antoxa78/Matrix_Clock_v3/(list of files, cad)

Other CAD files:
hardware/滤光板/挡板1.dwg
