antoxa78/Matrix_Clock_v3/sch.PDF

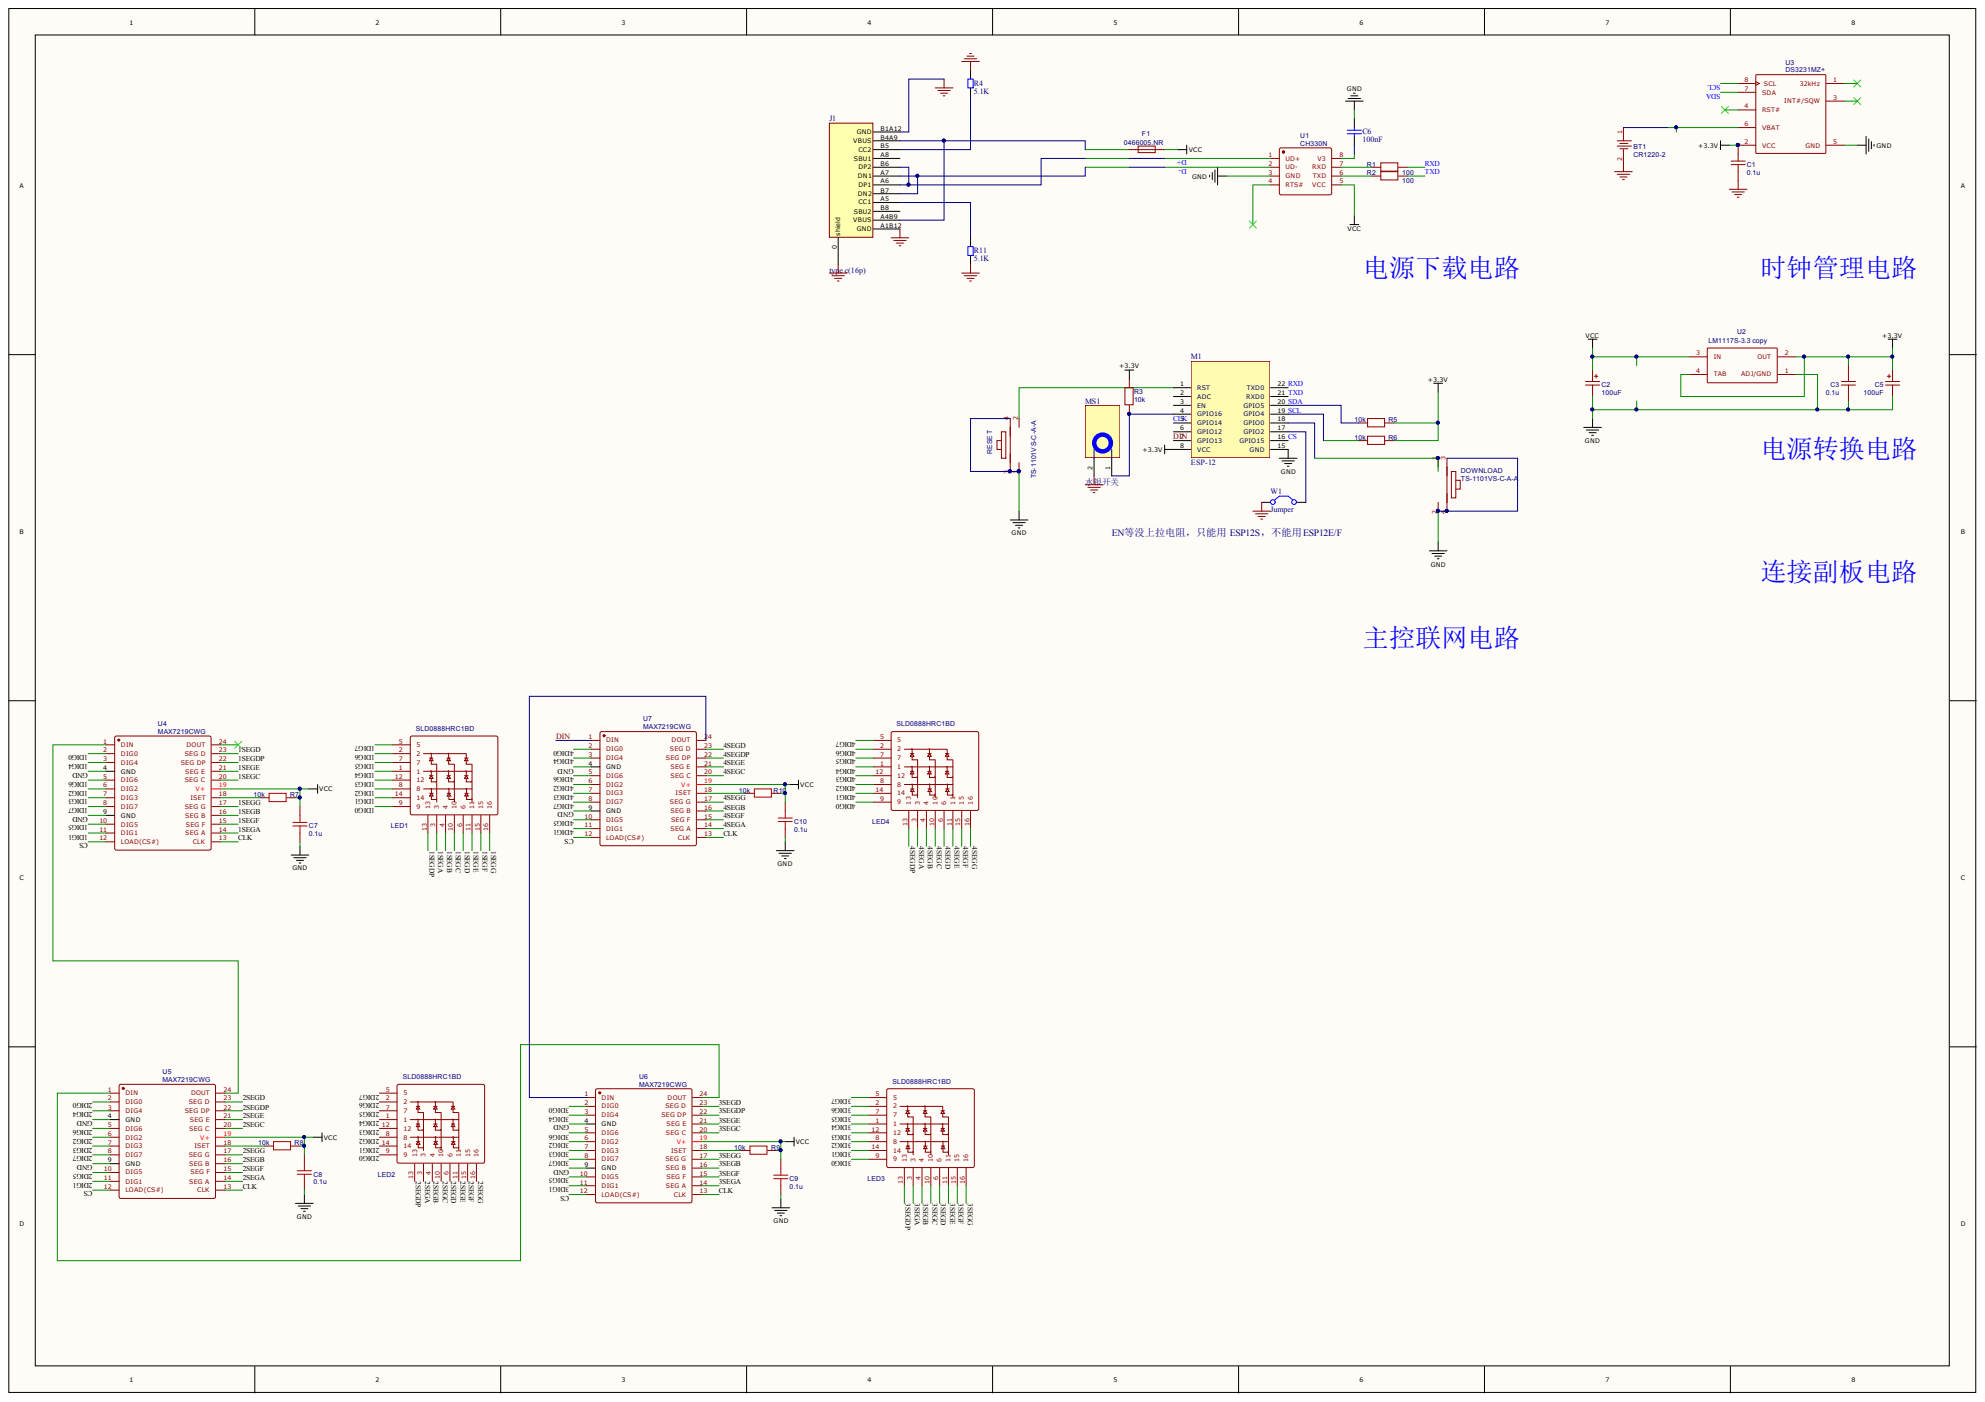
[picture p1: page 1]

R3 10k MS1 | | ADC 2

GPIO16 4 | | SCL
CLK | GPIO14 5
GPIO12 6 | | | 10k | R6
DIN | GPIO13 7 | | CS

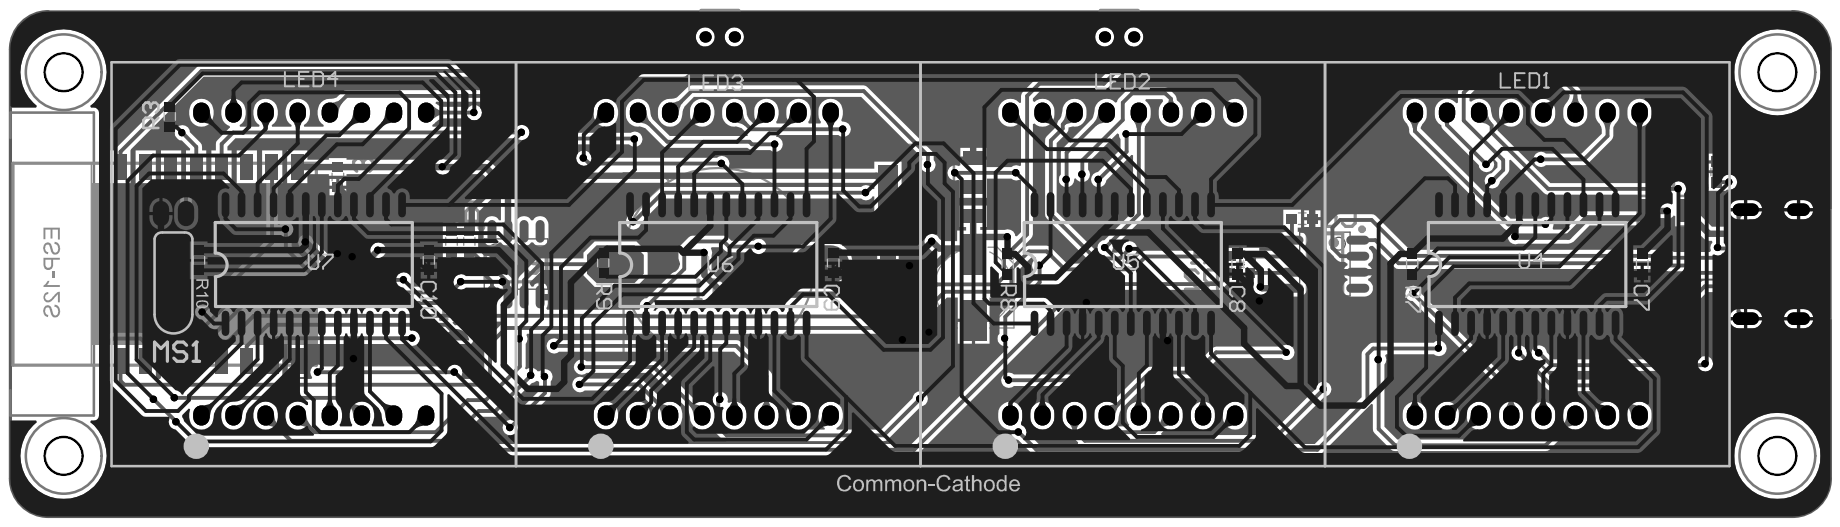
[picture p2: page 2]

Comment | Description | Designator | Footprint | LibRef | Quantity
CR1220-2 | | BT1 | CR1220座 | CR1220-2 | 1
0.1u | | C1, C3, C7, C8, C9, C10 | 0603(RC1608) | 0.1u | 6
100uF | | C2 | 6mm贴片电解 | 100uF | 1
100uF | | C5 | 0805(RC2012) | 100uF | 1
Cap | Capacitor | C6 | 0603(RC1608) | Cap | 1
TS-1101VS-C-A-A | | DOWNLOAD, RESET | KEY-SMD_4P-L7.8-W2.8-P4.20-EH | TS-1101VS-C-A-A | 2
0466005.NR | | F1 | LC-1206_R | 0466005.NR | 1
type c(16p) | | J1 | Type C(16P) | type c(16p) | 1
SLD0888HRC1BD | | LED1, LED2, LED3, LED4 | F3.0 LED DOT MATRIX | SLD0888HRC1BD | 4
ESP-12 | | M1 | ESP-12F贴片简化 | ESP-12 | 1
水银开关 | | MS1 | 水银开关2 | 水银开关 | 1
100 | | R1, R2 | 0603(RC1608) | 100 | 2
10k | | R3, R5, R6, R7, R8, R9, R10 | 0603(RC1608) | 10k | 7
5.1K | | R4, R11 | 0603(RC1608) | RES2 | 2
CH330N | | U1 | LC-SOP-8_150mil | CH330N | 1
LM1117S-3.3 copy | | U2 | SOT-223 | LM1117S-3.3 copy | 1
DS3231MZ+ | | U3 | LC-SOP-8_150mil | DS3231MZ+ | 1
MAX7219CWG | | U4, U5, U6, U7 | SOIC-24_L15.4-W7.5-P1.27-LS10.3-BL | MAX7219CWG | 4
Jumper | Jumper Wire | W1 | 跳线焊盘 | Jumper | 1
