antoxa78/Matrix_Clock_v3/hardware/hack_clock.kicad_pcb

## KiCad design hardware/hack_clock.kicad_pcb (2026-08-15)

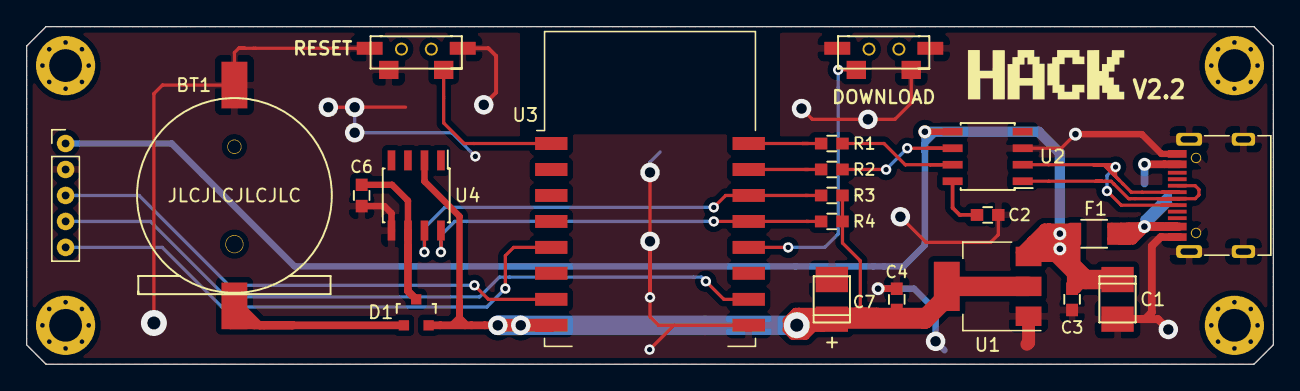
[picture p3: board hack_clock.kicad_pcb from above]

Board: 2 copper layers, 96.0 x 26.0 mm, 23 parts (1 on the bottom side), 20 nets.

Parts:
BT1: BATTERY(M); CR1220-SMD
C1, C7: 100uF; TantalC_SizeT_3528
C2, C6: 0.1uF; 0603_C
C3, C4: 1uF; 0603_C
D1: BAT54C; SOT-23
F1: FUSE*; F_1206
J1: Conn_01x05_Male; PinHeader_1x05_P2.00mm_Vertical
J2: Jack-DC; BarrelJack_DCDC-SMT
P3: USB_C_Plug_USB2.0; USB-Type-C-NEW
P665: CON_1; CON1
R1, R2: RES(M); 0603_R
R3, R4: 10K; 0603_R
SW1, SW2: switch; SWITCH_PUSH
U1: AMS1117; SOT-223-3_TabPin2
U2: CH340N; SOP-8
U3: ESP-12; ESP-12S
U4: DS3231MZ+; SOP-8

Connections:
+3V3: C4.2, C7.1, D1.2, R3.2, R4.2, U1.2, U3.8, U4.2
+5V: C1.1, C3.2, F1.2, J1.1, U1.3, U2.5
/CLK: J1.5, U3.5
/CS: J1.4, U3.16
/DIN: J1.3, U3.7
/RXD: R1.2, U3.22
/SCL: R4.1, U3.19, U4.8
/SDA: R3.1, U3.20, U4.7
/TXD: R2.2, U3.21
/USB_D+: P3.A6, U2.1
/USB_D-: P3.A7, U2.2
GND: BT1.2, C1.2, C2.1, C3.1, C4.1, C6.1, C7.2, J1.2, J2.2, P3.A1, P3.S1, SW1.1, SW2.1, U1.1, U2.3, U3.15, U4.5
unnamed: BT1.1, D1.1
unnamed: C2.2, U2.8
unnamed: C6.2, D1.3, U4.6
unnamed: F1.1, J2.1, P3.A4
unnamed: R1.1, U2.7
unnamed: R2.1, U2.6
unnamed: SW1.2, U3.1
unnamed: SW2.2, U3.18
