antoxa78/Matrix_Clock_v3/hardware/matrix display_v2.1/matrix_display.kicad_pcb

## KiCad design hardware/matrix display_v2.1/matrix_display.kicad_pcb (2026-08-15)

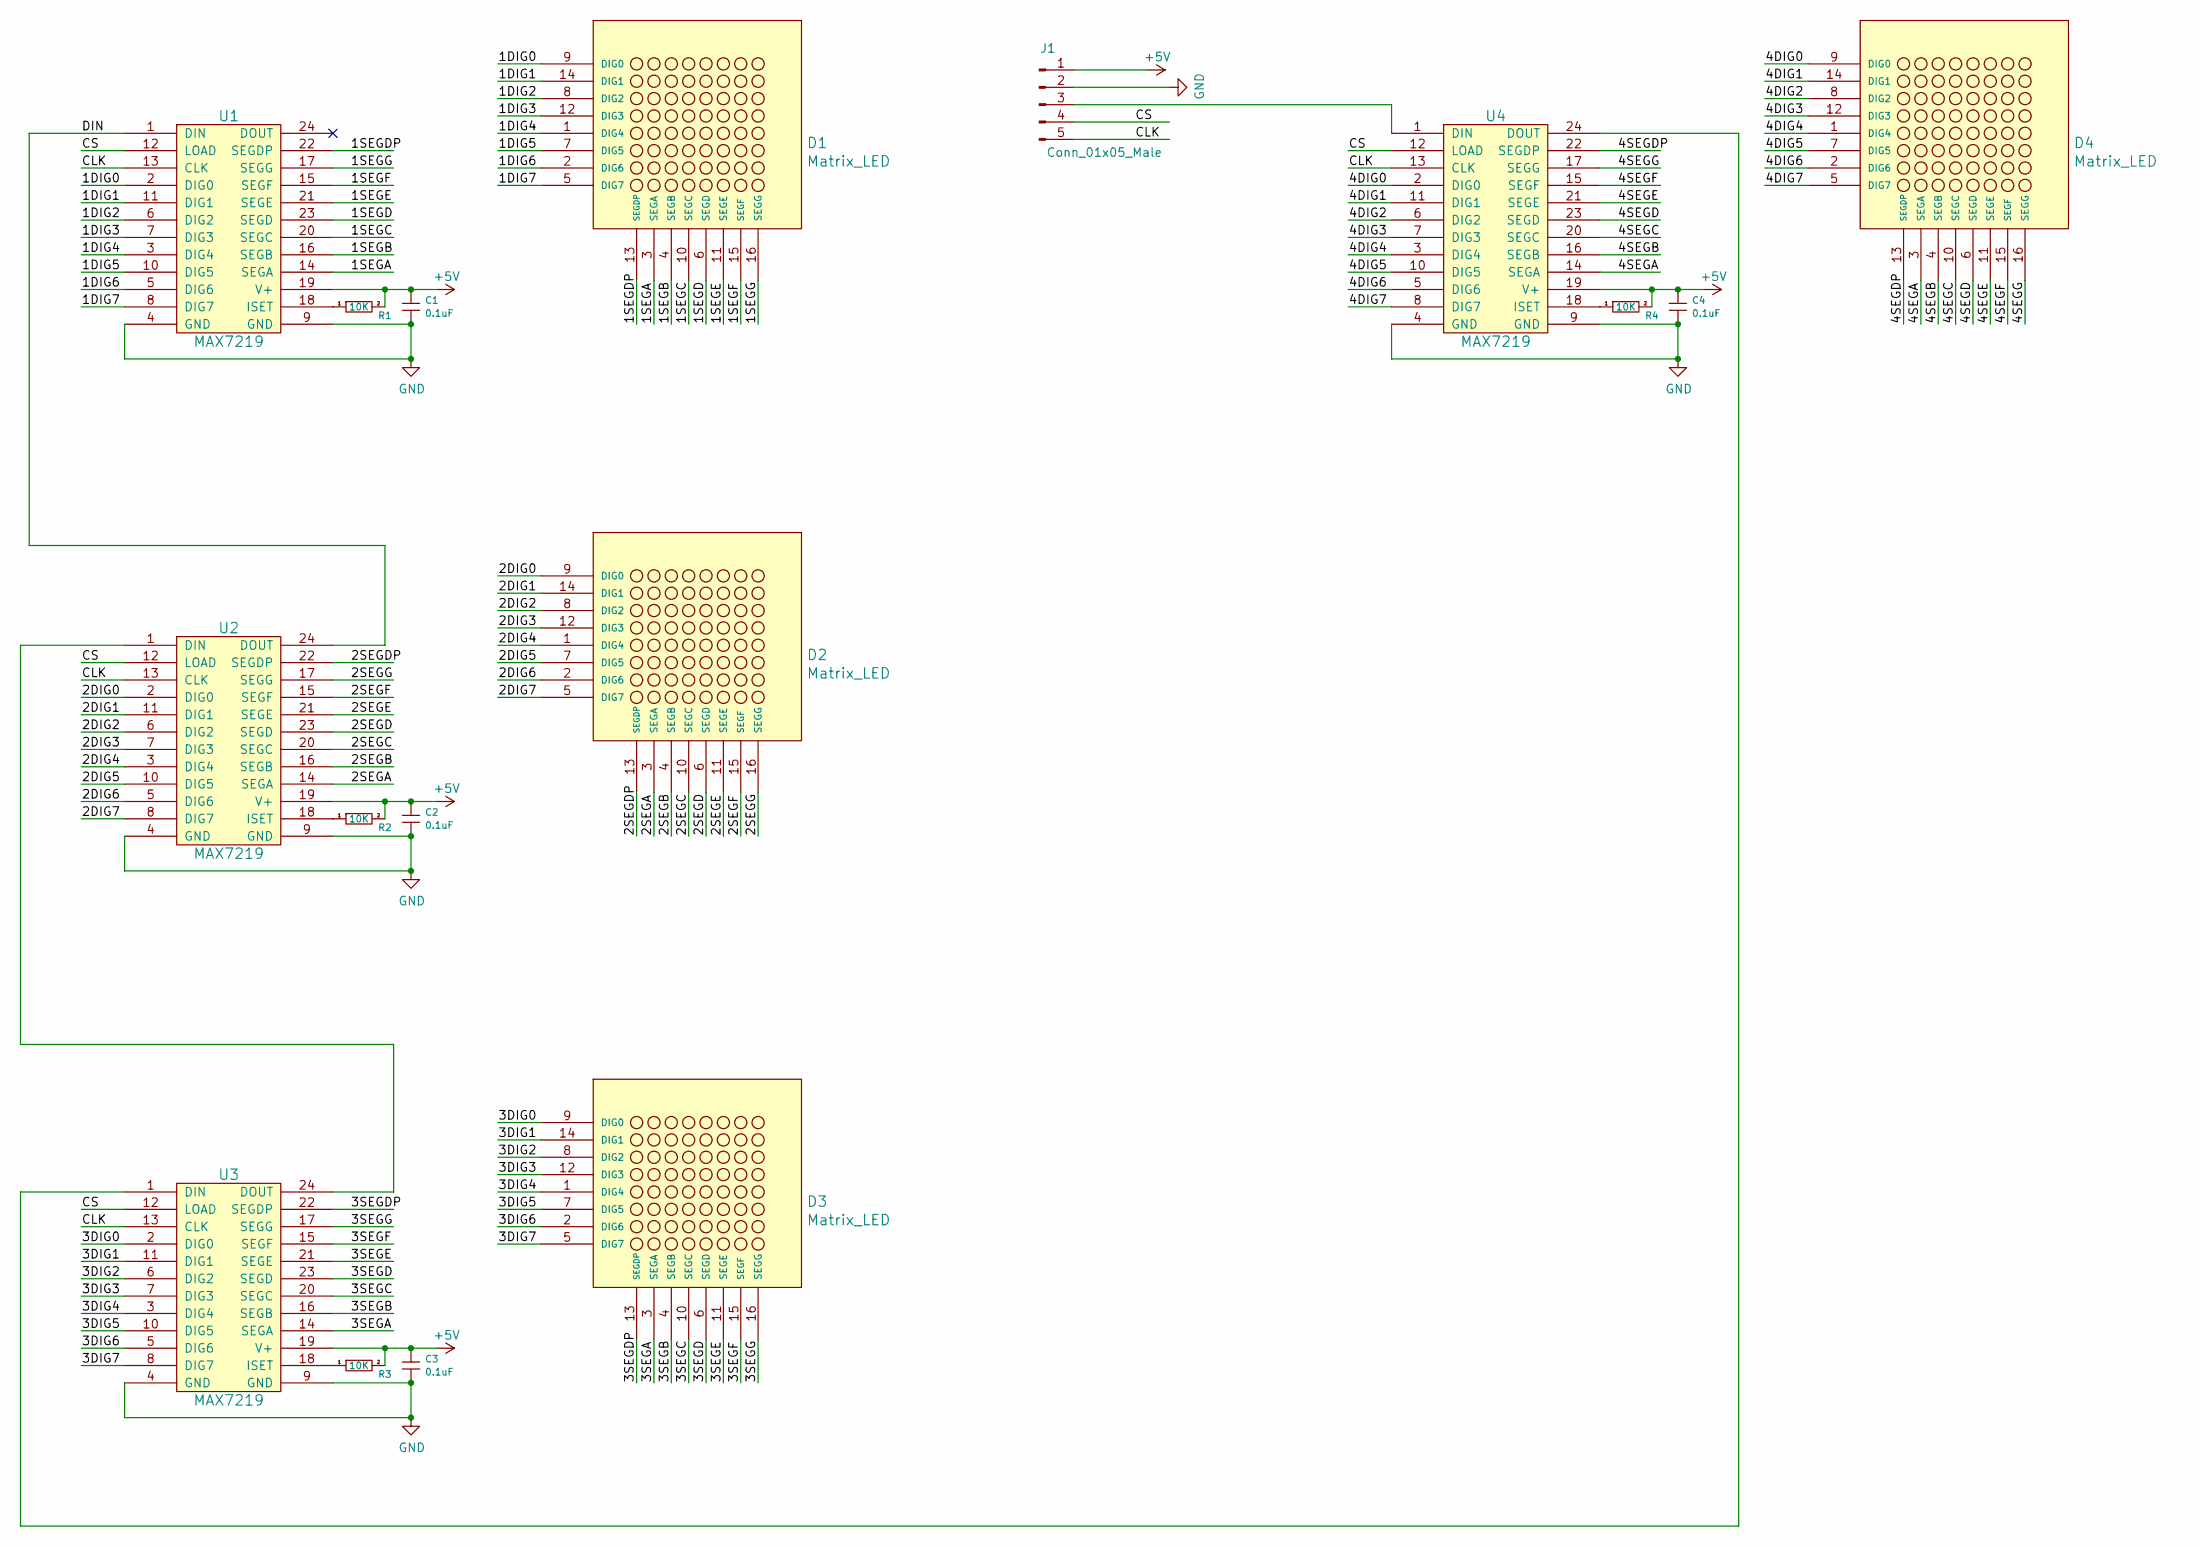
[picture p4: schematic matrix_display.sch]

Parts:
C1, C2, C3, C4: 0.1uF; 0603_C
D1, D2, D3, D4: Matrix_LED
J1: Conn_01x05_Male; PinHeader_1x05_P2.00mm_Vertical
R1, R2, R3, R4: 10K; 0603_R
U1, U2, U3, U4: MAX7219; SOIC-24W_7.5x15.4mm_P1.27mm

Connections:
+5V: C1.1, C2.1, C3.1, C4.1, J1.1, R1.2, R2.2, R3.2, R4.2, U1.19 (V+), U2.19 (V+), U3.19 (V+), U4.19 (V+)
/1DIG0: D1.9 (DIG0), U1.2 (DIG0)
/1DIG1: D1.14 (DIG1), U1.11 (DIG1)
/1DIG2: D1.8 (DIG2), U1.6 (DIG2)
/1DIG3: D1.12 (DIG3), U1.7 (DIG3)
/1DIG4: D1.1 (DIG4), U1.3 (DIG4)
/1DIG5: D1.7 (DIG5), U1.10 (DIG5)
/1DIG6: D1.2 (DIG6), U1.5 (DIG6)
/1DIG7: D1.5 (DIG7), U1.8 (DIG7)
/1SEGA: D1.3 (SEGA), U1.14 (SEGA)
/1SEGB: D1.4 (SEGB), U1.16 (SEGB)
/1SEGC: D1.10 (SEGC), U1.20 (SEGC)
/1SEGD: D1.6 (SEGD), U1.23 (SEGD)
/1SEGDP: D1.13 (SEGDP), U1.22 (SEGDP)
/1SEGE: D1.11 (SEGE), U1.21 (SEGE)
/1SEGF: D1.15 (SEGF), U1.15 (SEGF)
/1SEGG: D1.16 (SEGG), U1.17 (SEGG)
/2DIG0: D2.9 (DIG0), U2.2 (DIG0)
/2DIG1: D2.14 (DIG1), U2.11 (DIG1)
/2DIG2: D2.8 (DIG2), U2.6 (DIG2)
/2DIG3: D2.12 (DIG3), U2.7 (DIG3)
/2DIG4: D2.1 (DIG4), U2.3 (DIG4)
/2DIG5: D2.7 (DIG5), U2.10 (DIG5)
/2DIG6: D2.2 (DIG6), U2.5 (DIG6)
/2DIG7: D2.5 (DIG7), U2.8 (DIG7)
/2SEGA: D2.3 (SEGA), U2.14 (SEGA)
/2SEGB: D2.4 (SEGB), U2.16 (SEGB)
/2SEGC: D2.10 (SEGC), U2.20 (SEGC)
/2SEGD: D2.6 (SEGD), U2.23 (SEGD)
/2SEGDP: D2.13 (SEGDP), U2.22 (SEGDP)
/2SEGE: D2.11 (SEGE), U2.21 (SEGE)
/2SEGF: D2.15 (SEGF), U2.15 (SEGF)
/2SEGG: D2.16 (SEGG), U2.17 (SEGG)
/3DIG0: D3.9 (DIG0), U3.2 (DIG0)
/3DIG1: D3.14 (DIG1), U3.11 (DIG1)
/3DIG2: D3.8 (DIG2), U3.6 (DIG2)
/3DIG3: D3.12 (DIG3), U3.7 (DIG3)
/3DIG4: D3.1 (DIG4), U3.3 (DIG4)
/3DIG5: D3.7 (DIG5), U3.10 (DIG5)
/3DIG6: D3.2 (DIG6), U3.5 (DIG6)
/3DIG7: D3.5 (DIG7), U3.8 (DIG7)
/3SEGA: D3.3 (SEGA), U3.14 (SEGA)
/3SEGB: D3.4 (SEGB), U3.16 (SEGB)
/3SEGC: D3.10 (SEGC), U3.20 (SEGC)
/3SEGD: D3.6 (SEGD), U3.23 (SEGD)
/3SEGDP: D3.13 (SEGDP), U3.22 (SEGDP)
/3SEGE: D3.11 (SEGE), U3.21 (SEGE)
/3SEGF: D3.15 (SEGF), U3.15 (SEGF)
/3SEGG: D3.16 (SEGG), U3.17 (SEGG)
/4DIG0: D4.9 (DIG0), U4.2 (DIG0)
/4DIG1: D4.14 (DIG1), U4.11 (DIG1)
/4DIG2: D4.8 (DIG2), U4.6 (DIG2)
/4DIG3: D4.12 (DIG3), U4.7 (DIG3)
/4DIG4: D4.1 (DIG4), U4.3 (DIG4)
/4DIG5: D4.7 (DIG5), U4.10 (DIG5)
/4DIG6: D4.2 (DIG6), U4.5 (DIG6)
/4DIG7: D4.5 (DIG7), U4.8 (DIG7)
/4SEGA: D4.3 (SEGA), U4.14 (SEGA)
/4SEGB: D4.4 (SEGB), U4.16 (SEGB)
/4SEGC: D4.10 (SEGC), U4.20 (SEGC)
/4SEGD: D4.6 (SEGD), U4.23 (SEGD)
/4SEGDP: D4.13 (SEGDP), U4.22 (SEGDP)
/4SEGE: D4.11 (SEGE), U4.21 (SEGE)
/4SEGF: D4.15 (SEGF), U4.15 (SEGF)
/4SEGG: D4.16 (SEGG), U4.17 (SEGG)
/CLK: J1.5, U1.13 (CLK), U2.13 (CLK), U3.13 (CLK), U4.13 (CLK)
/CS: J1.4, U1.12 (LOAD), U2.12 (LOAD), U3.12 (LOAD), U4.12 (LOAD)
/DIN: U1.1 (DIN), U2.24 (DOUT)
GND: C1.2, C2.2, C3.2, C4.2, J1.2, U1.4 (GND), U1.9 (GND), U2.4 (GND), U2.9 (GND), U3.4 (GND), U3.9 (GND), U4.4 (GND), U4.9 (GND)
unnamed: J1.3, U4.1 (DIN)
unnamed: R1.1, U1.18 (ISET)
unnamed: R2.1, U2.18 (ISET)
unnamed: R3.1, U3.18 (ISET)
unnamed: R4.1, U4.18 (ISET)
unnamed: U2.1 (DIN), U3.24 (DOUT)
unnamed: U3.1 (DIN), U4.24 (DOUT)

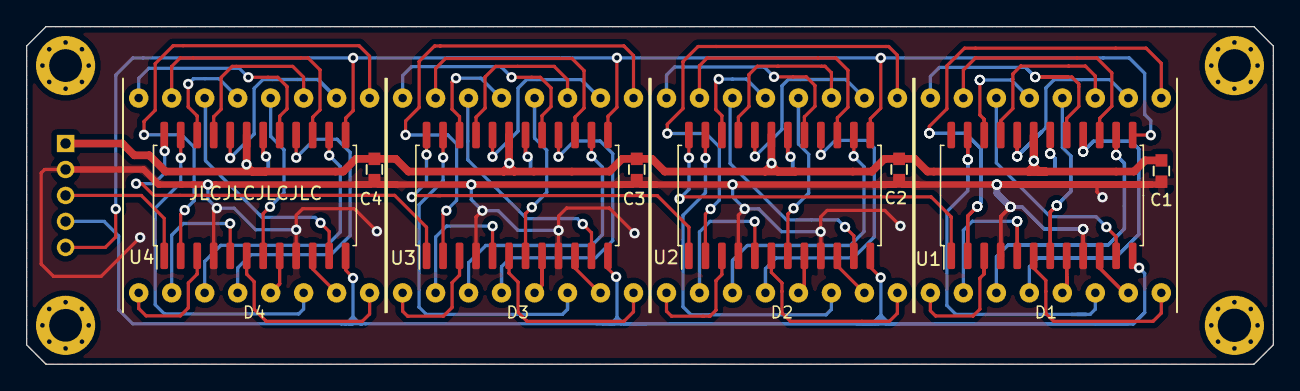
[picture p5: board matrix_display.kicad_pcb from above]

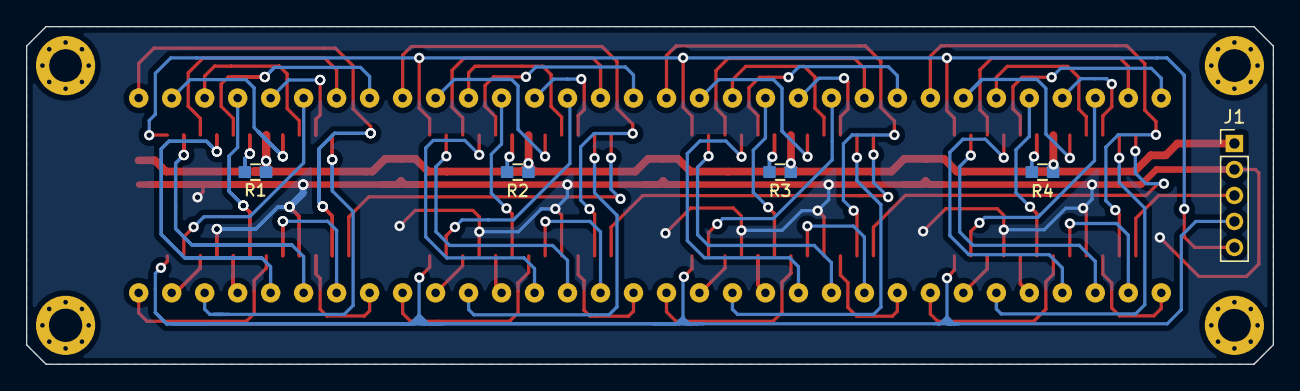
[picture p6: board matrix_display.kicad_pcb from below]

Board: 2 copper layers, 96.0 x 26.0 mm, 17 parts (5 on the bottom side), 76 nets.
