antoxa78/Matrix_Clock_v3/firmware/MatrixClock/MatrixClock.ino

/*********************************************************************************************************
  HACK LABS MatrixClock                                                                                 
  ********************************************************************************************************
  Author: HACK Lab                                                                                     
  YouTube ID: HACK Lab, welcome to subscribe: https://www.youtube.com/channel/UCxFY1FcIYK9d7riTvIh6eiA                                                          
  Version 2.4
  HACK_CLOCK is a free download and may be used, modified, evaluated and
  distributed without charge provided the user adheres to version three of the GNU
  General Public License (GPL) and does not remove the copyright notice or this
  text.  The GPL V3 text is available on the gnu.org web site
  Author: HACK Lab                                                                                        
  Bilibili ID: HACK Lab  welcome to subscribe: https://space.bilibili.com/395145107                                                                             
  WeChat Official Account: HACK Lab, the only release point for open-source resources, regularly sharing open-source hardware and valuable technical articles, welcome to follow.                        
  Version 2.4                                                                                           
  HACK_CLOCK is a fully open-source hardware project, free to download and use, subject to the GPL V3 open-source license, the license text is available on the gnu.org website.    
*********************************************************************************************************/

#include <SPI.h>
#include <Ticker.h>
#include <ESP8266WiFi.h>
#include <WiFiClient.h>
#include <WiFiUdp.h>
#include <Wire.h>
#include <time.h>
#include <EEPROM.h>
#include <ESP8266WebServer.h>
#include <ESP8266HTTPClient.h>
#include <stdarg.h>
#include "WebPage.h"
#include "WebCss.h"
#include "WebJs.h"
#include "WebAssetsGz.h"

#define SDA        5      // Pin sda (I2C)
#define SCL        4      // Pin scl (I2C)
#define CS         15     // Pin cs  (SPI)
#define anzMAX     4        // number of dot matrix modules
#define WIFI_CHECK_INTERVAL 30  // seconds between WiFi status checks
#define FIRMWARE_VERSION "v5.7.24"   // shown on the settings page

// Display-change transition animations.
enum {
    TRANSITION_OFF = 0,
    TRANSITION_PACMAN,
    TRANSITION_WIPE,
    TRANSITION_DISSOLVE,
    TRANSITION_BLINDS,
    TRANSITION_CHECKER,
    TRANSITION_MELT,
    TRANSITION_MATRIX,
    TRANSITION_SLIDE,
    TRANSITION_SPARKLE,
    TRANSITION_SNAKE,
    TRANSITION_BARN,
    TRANSITION_BREAKOUT,   // removed; value kept so saved settings keep their numbering
    TRANSITION_SPACE,
    TRANSITION_TETRIS,
    TRANSITION_RANDOM
};

#define PACMAN_FRAMES 83   // about 4.2 seconds at 50 ms per frame
#define GAME_FRAMES 60     // about 3 seconds for the other game animations

// Rain warning tuning. The current rain rate uses settings.rainThresh10;
// these values control the forecast-based part of the warning.
#define RAIN_PROB_MIN          60    // % chance required for a forecast warning
#define RAIN_PROB_NOW_MIN      50    // % chance required for a "rain code now" warning
#define RAIN_AMOUNT_1H_MM      0.3   // mm expected in the next hour
#define RAIN_AMOUNT_2H_MM      0.6   // mm expected in the next two hours
#define RAIN_CODE_AMOUNT_2H_MM 0.1   // minimum forecast amount for a code-only warning
#define WEATHER_STALE_MIN      45    // data older than this is stale (or 3 intervals)
//#define REVERSE_HORIZONTAL
//#define REVERSE_VERTICAL
//***************************Web Settings Page**********************************************************************
// configurable settings, stored in EEPROM, editable via http://<clock-ip>/
#define BIRTHDAY_MAX 6
struct BirthdayEntry {
    char name[20];
    uint8_t day;
    uint8_t month;
    uint16_t year;   // 0 = no age shown
};
struct ClockSettings {
    uint32_t magic;          // 0xA5A5A5A5 if settings are valid
    char ssid[32];
    char pass[64];
    char ntpServer[64];
    int8_t tzOffset;         // hours, e.g. 8 = UTC+8
    uint8_t brightness;      // 0-15
    uint8_t orient;          // 1 = normal, 2 = flipped
    uint8_t scrollDate;      // 0 = off, 1 = on
    uint8_t scrollDir;       // 0 = Up-Down, 1 = Down-Up
    uint8_t resync;          // 0 = off, 1 = on
    uint8_t resyncHour;      // 0-23
    uint8_t resyncMin;       // 0-59
    uint8_t dstRule;         // 0 = off, 1 = Israel, 2 = EU, 3 = US
    uint8_t colonAnim;       // colon animation: 0=solid, 1=blink 1Hz, 2=blink slow, 3=double flash, 4=alternate dots, 5=center out
    uint8_t marquee;         // legacy, keep for EEPROM layout
    uint8_t pulse;           // legacy, keep for EEPROM layout
    uint16_t ntpInterval;    // periodic NTP sync interval in minutes, 0 = off
    uint8_t weather;         // 0 = off, 1 = on
    char weatherCity[40];    // city name for weather lookup
    uint16_t weatherInterval; // weather update interval in minutes
    int32_t weatherLat;      // cached latitude  * 1e6 (geocoded from city)
    int32_t weatherLon;      // cached longitude * 1e6
    uint8_t weatherSpeed;    // weather message scroll speed: 1=slow, 2=normal, 3=fast
    uint16_t scrollDateInt;  // minutes between date scrolls (default 1 = every minute)
    uint8_t rainWarn;        // 0 = off, 1 = show RAIN WARNING when precipitation >= threshold
    uint8_t heatWarn;        // 0 = off, 1 = show HEAT WARNING when temperature >= threshold
    uint8_t rainThresh;      // legacy whole-mm rain threshold (kept for older firmware)
    uint8_t heatThresh;      // legacy whole-°C heat threshold (kept for older firmware)
    uint8_t digitAnim;       // digit change animation: 0=off, 1=roll, 2=flip, 3=wipe, 4=fade, 5=drop
    uint8_t weatherCityShow; // 0 = hide city name in weather message, 1 = show it
    uint8_t warnAnim;        // 0 = off, 1 = show a short rain/heat animation before the warning text
    uint8_t shabbat;         // 0 = off, 1 = announce Shabbat candle lighting / end times
    uint8_t shabbatLead;     // minutes before candle lighting to start announcing (10-240, default 60)
    char webPass[32];        // optional HTTP Basic auth password for the web UI (empty = no auth)
    uint8_t shabbatFreq;     // repeat Shabbat message every N minutes (5-60, default 10)
    uint8_t shabbatAnim;     // 0 = text only, 1 = candle / Star of David animation
    uint8_t holidayGreetings; // 0 = off, 1 = show New Year / Christmas / Hebrew holiday greetings
    uint16_t rainThresh10;   // rain warning threshold in 0.1 mm (12 = 1.2 mm)
    uint16_t heatThresh10;   // heat warning threshold in 0.1 °C (355 = 35.5 °C)
    uint16_t threshFormat;   // 0xA55A when the tenths fields above are valid
    uint8_t birthdayEnabled; // 0 = off, 1 = show birthday greetings
    uint8_t birthdayFreq;    // repeat interval in minutes (0 = once per day)
    uint8_t birthdayAnim;    // 0 = text only, 1 = birthday animation
    BirthdayEntry birthdays[BIRTHDAY_MAX];
    uint16_t birthdayFormat; // 0xB17D when the birthday fields are valid
    uint8_t holidayFreq;     // holiday greeting repeat interval in minutes (0 = once/day)
    uint16_t greetingFormat; // 0xB17E when the holiday frequency field is valid
    uint8_t weatherDetails;  // 0 = off, 1 = rotate weather detail messages
    uint16_t detailFormat;   // 0xDE7A when the weatherDetails field is valid
    uint8_t textEffect;      // message effect: 0=scroll, 1=fade, 4=blink
    uint16_t textFxFormat;   // 0xEFF5 when the textEffect field is valid
    uint8_t dateSpeed;       // date scroll speed: 1=slow, 2=normal, 3=fast
    uint16_t dateSpeedFormat; // 0xDA7E when the dateSpeed field is valid
    uint8_t displayTransition; // 0=off, 1=Pac-Man, 2..11 animations, 12=random order
    uint16_t transitionFormat; // 0xD158 when the displayTransition field is valid
    char apPass[64];          // password for the MatrixClock-Setup AP
    uint16_t apPassFormat;    // 0xAB12 when apPass is valid
};
ClockSettings settings = { 0xA5A5A5A5, "", "", "il.pool.ntp.org", 2, 3, 1, 1, 0, 1, 0, 20, 0, 0, 0, 0, 0, 1, "", 30, 0, 0, 2, 1, 1, 1, 2, 31, 1, 1, 1, 1, 60, "", 10, 1, 1, 20, 310, 0xA55A, 1, 60, 1, {}, 0xB17D, 0, 0xB17E, 1, 0xDE7A, 0, 0xEFF5, 2, 0xDA7E, 1, 0xD158, "12345678", 0xAB12 };
const ClockSettings settings_defaults = { 0xA5A5A5A5, "", "", "il.pool.ntp.org", 2, 3, 1, 1, 0, 1, 0, 20, 0, 0, 0, 0, 0, 1, "", 30, 0, 0, 2, 1, 1, 1, 2, 31, 1, 1, 1, 1, 60, "", 10, 1, 1, 20, 310, 0xA55A, 1, 60, 1, {}, 0xB17D, 0, 0xB17E, 1, 0xDE7A, 0, 0xEFF5, 2, 0xDA7E, 1, 0xD158, "12345678", 0xAB12 };
bool rtcInitialized = false;
bool apActive = false;              // AP fallback mode active (settings page accessible)
bool apShutdownPending = false;     // stopAP ran; softAP shutdown deferred to a quieter moment
unsigned long apShutdownSince = 0;  // millis() when the softAP shutdown was scheduled
bool apUpdateMode = false;          // user requested the setup AP for a firmware update
unsigned long apUpdatePending = 0;  // millis() when the AP switch should happen
unsigned long apUpdateSince = 0;    // millis() when AP update mode started

unsigned short maxPosX = anzMAX * 8 - 1;            
unsigned short LEDarr[anzMAX][8];                   
unsigned short helpArrMAX[anzMAX * 8];              
unsigned short helpArrPos[anzMAX * 8];              
int z_PosX = 0;                            
int d_PosX = 0;                            
bool showMsg = false;                                // a message is scrolling across the display
char msg[120] = "";
uint8_t msgStep = 2;                                 // current message scroll speed (px per 50ms tick)
bool msgEatActive = false;                             // a display-change transition is running
bool msgEatPending = false;                            // a message waits for the transition to finish
uint8_t msgEatFrame = 0;
uint16_t msgEatSnapshot[anzMAX][8];                    // previous display frame
uint8_t transitionType = TRANSITION_PACMAN;
uint8_t transitionSeed = 0;
uint8_t transitionDir = 0;
uint8_t transitionBag[TRANSITION_TETRIS];
uint8_t transitionBagPos = 0;
uint8_t transitionBagCount = 0;
uint8_t lastRandomType = 0;
uint32_t rngState = 0x9E3779B9UL;
#define MSG_QUEUE_SIZE 3
char msgQueue[MSG_QUEUE_SIZE][120];
uint8_t msgQueueStep[MSG_QUEUE_SIZE];
uint8_t msgQueueCount = 0;
unsigned long apMsgUntil = 0;                        // AP-mode message keeps repeating until this time
bool shabbatValid = false;
uint16_t shabbatCandleMin = 0;
uint16_t shabbatHavdalahMin = 0;

#define HOLIDAY_MAX 24
struct HolidayEntry {
    uint8_t day;
    uint8_t type;
};
HolidayEntry holidayList[HOLIDAY_MAX];
uint8_t holidayCount = 0;
uint16_t holidayFetchMonth = 0;
bool holidayFetchOk = false;
unsigned long holidayLastFetch = 0;
uint32_t holidayGreetedKey = 0;

enum {
    ALERT_ANIM_NONE = 0,
    ALERT_ANIM_RAIN,
    ALERT_ANIM_HEAT,
    ALERT_ANIM_CANDLES,
    ALERT_ANIM_SHABBAT_END,
    ALERT_ANIM_FIREWORKS,
    ALERT_ANIM_CHRISTMAS,
    ALERT_ANIM_SHOFAR,
    ALERT_ANIM_MENORAH,
    ALERT_ANIM_TREE,
    ALERT_ANIM_MASK,
    ALERT_ANIM_MATZAH,
    ALERT_ANIM_TORAH,
    ALERT_ANIM_SUKKAH,
    ALERT_ANIM_FLAG,
    ALERT_ANIM_MEMORIAL,
    ALERT_ANIM_BONFIRE,
    ALERT_ANIM_BIRTHDAY
};
enum {
    HOLIDAY_NONE = 0,
    HOLIDAY_NEW_YEAR,
    HOLIDAY_CHRISTMAS,
    HOLIDAY_ROSH_HASHANA,
    HOLIDAY_YOM_KIPPUR,
    HOLIDAY_SUKKOT,
    HOLIDAY_SIMCHAT_TORAH,
    HOLIDAY_HANUKKAH,
    HOLIDAY_TU_BISHVAT,
    HOLIDAY_PURIM,
    HOLIDAY_PESACH,
    HOLIDAY_SHAVUOT,
    HOLIDAY_TISHA_BAV,
    HOLIDAY_LAG_BAOMER,
    HOLIDAY_YOM_HASHOAH,
    HOLIDAY_YOM_HAZIKARON,
    HOLIDAY_YOM_HAATZMAUT,
    HOLIDAY_YERUSHALAYIM,
    HOLIDAY_SIGD,
    HOLIDAY_HERZL,
    HOLIDAY_JABOTINSKY,
    HOLIDAY_BEN_GURION,
    HOLIDAY_RABIN,
    HOLIDAY_SWORDS_IRON,
    HOLIDAY_ALIYAH
};
bool alertAnimActive = false;
uint8_t alertAnimType = ALERT_ANIM_NONE;
unsigned long alertAnimStartMs = 0;
uint8_t alertAnimSpeed = 2;
char alertAnimMsg[120] = "";
const unsigned long ALERT_ANIM_MS = 2500UL;   // 2.5 s at the 50 ms frame rate
bool weatherAlertActive = false;              // rain/heat warning owns the display
bool weatherAlertMsgActive = false;           // the warning text itself is scrolling
bool weatherDataValid = false;                // last weather fetch succeeded
float weatherTempC = 0;
float weatherPrecipRate = 0;                  // current rain rate, mm/h
float weatherRainPeak = 0;                    // peak rain rate in the next 2 h, mm/h
int weatherHumidity = 0;
int weatherCode = 0;
unsigned long weatherUpdatedMs = 0;
char weatherDataCity[sizeof(settings.weatherCity)] = "";
int weatherPrecipProb = 0;                    // max precipitation probability in the next 2 h, %
float weatherRain1h = 0;                      // expected rain in the next hour, mm
float weatherRain2h = 0;                      // expected rain in the next two hours, mm
bool weatherRainCodeSoon = false;             // a rain WMO code is forecast in the next 2 h
bool weatherRainLatched = false;              // hysteresis: warning survives one dry check
uint8_t weatherRainDryChecks = 0;             // consecutive dry checks while latched
float weatherRainLastRate = 0;                // last active values, used for "RAIN ENDING"
float weatherRainLast1h = 0;
int weatherRainLastProb = 0;
float weatherHighC = 0;
float weatherLowC = 0;
float weatherUv = 0;
float weatherWindKmh = 0;
float weatherPressureHpa = 0;
int weatherWindDir = 0;
int weatherDailyProb = 0;
char weatherSunrise[6] = "";
char weatherSunset[6] = "";
bool weatherDetailsValid = false;
bool weatherHighValid = false;
bool weatherLowValid = false;
uint16_t weatherDetailCount = 0;
uint8_t weatherDetailLastPage = 0;
bool f_tckr1s = false;
bool f_tckr50ms = false;
bool kk;
unsigned long epoch = 0;
unsigned int localPort = 2390;                      // local port to listen for UDP packets
const int NTP_PACKET_SIZE = 48;                     // NTP time stamp is in the first 48 bytes of the message
byte packetBuffer[NTP_PACKET_SIZE];                 // buffer to hold incoming and outgoing packets
IPAddress timeServerIP;                            
unsigned long ntpLastRttMs = 0;                     // last measured NTP round-trip time
unsigned long ntpLastTransitMs = 0;                 // one-way correction applied to the server timestamp
unsigned long ntpLastSyncMs = 0;                    // millis() of the last successful NTP sync
unsigned long ntpRetryAt = 0;                       // millis() of the next automatic NTP retry
uint8_t ntpRetryCount = 0;                          // failed retry attempts since the last success

#define LOG_LINES 16
#define LOG_CHARS 96
struct LogEntry {
    unsigned long ms;
    char text[LOG_CHARS];
};
LogEntry logRing[LOG_LINES];
uint8_t logHead = 0;
uint8_t logCount = 0;
volatile unsigned long loopHeartbeatMs = 0;
volatile bool otaUploadInProgress = false;
uint32_t heapMin = 0xFFFFFFFF;
uint16_t wifiReconnectCount = 0;
char lastNtpError[64] = "";
char lastWeatherError[64] = "";
unsigned long displayTestStart = 0;
unsigned long displayTestUntil = 0;

void logLine(const char* fmt, ...)
{
    char buf[LOG_CHARS];
    va_list ap;
    va_start(ap, fmt);
    vsnprintf(buf, sizeof buf, fmt, ap);
    va_end(ap);
    Serial.println(buf);
    LogEntry &e = logRing[logHead];
    e.ms = millis();
    strncpy(e.text, buf, sizeof e.text - 1);
    e.text[sizeof e.text - 1] = 0;
    logHead = (uint8_t) ((logHead + 1) % LOG_LINES);
    if (logCount < LOG_LINES) logCount++;
}

const unsigned char DS3231_ADDRESS = 0x68;
const unsigned char secondREG = 0x00;
const unsigned char minuteREG = 0x01;
const unsigned char hourREG = 0x02;
const unsigned char WTREG = 0x03;                   //weekday
const unsigned char dateREG = 0x04;
const unsigned char monthREG = 0x05;
const unsigned char yearREG = 0x06;
const unsigned char alarm_min1secREG = 0x07;
const unsigned char alarm_min1minREG = 0x08;
const unsigned char alarm_min1hrREG = 0x09;
const unsigned char alarm_min1dateREG = 0x0A;
const unsigned char alarm_min2minREG = 0x0B;
const unsigned char alarm_min2hrREG = 0x0C;
const unsigned char alarm_min2dateREG = 0x0D;
const unsigned char controlREG = 0x0E;
const unsigned char statusREG = 0x0F;
const unsigned char ageoffsetREG = 0x10;
const unsigned char tempMSBREG = 0x11;
const unsigned char tempLSBREG = 0x12;
const unsigned char _24_hour_format = 0;
const unsigned char _12_hour_format = 1;
const unsigned char AM = 0;
const unsigned char PM = 1;

struct DateTime {
    unsigned short sek1, sek2, sek12, min1, min2, min12, std1, std2, std12;
    unsigned short tag1, tag2, tag12, mon1, mon2, mon12, jahr1, jahr2, jahr12, WT;// Tage=day, Monate=month, Jahre=year (German)
} MEZ;


// The object for the Ticker
Ticker tckr;
// A UDP instance to let us send and receive packets over UDP
WiFiUDP udp;


//months
char M_arr[12][5] = { { ' ', 'J', 'A', 'N', ' ' }, { ' ', 'F', 'E', 'B', ' ' },
        { ' ', 'M', 'A', 'R', ' ' }, { ' ', 'A', 'P', 'R', ' ' }, { ' ', 'M', 'A',
                'Y', ' ' }, { ' ', 'J', 'U', 'N', ' ' }, { ' ', 'J', 'U', 'L', ' ' }, {
                ' ', 'A', 'U', 'G', ' ' }, { ' ', 'S', 'E', 'P', ' ' }, { ' ', 'O', 'C',
                'T', ' ' }, { ' ', 'N', 'O', 'V', ' ' }, { ' ', 'D', 'E', 'C', ' ' } };
//days
char WT_arr[7][4] = { { 'S', 'U', 'N', ' ' }, { 'M', 'O', 'N', ' ' }, { 'T', 'U', 'E', ' ' }, {
        'W', 'E', 'D', ' ' }, { 'T', 'H', 'U', ' ' }, { 'F', 'R', 'I', ' ' }, { 'S', 'A', 'T', ' ' } };

// Font 5x8 in an 8x8 matrix, 0,0 is top right
unsigned short const font1[96][9] = { { 0x04, 0x00, 0x00, 0x00, 0x00, 0x00,
        0x00, 0x00, 0x00 },   // 0x20, Space (narrower 4px gap between words)
        { 0x07, 0x04, 0x04, 0x04, 0x04, 0x04, 0x00, 0x04, 0x00 },   // 0x21, !
        { 0x07, 0x09, 0x09, 0x12, 0x00, 0x00, 0x00, 0x00, 0x00 },   // 0x22, "
        { 0x07, 0x0a, 0x0a, 0x1f, 0x0a, 0x1f, 0x0a, 0x0a, 0x00 },   // 0x23, #
        { 0x07, 0x04, 0x0f, 0x14, 0x0e, 0x05, 0x1e, 0x04, 0x00 },   // 0x24, $
        { 0x07, 0x19, 0x19, 0x02, 0x04, 0x08, 0x13, 0x13, 0x00 },   // 0x25, %
        { 0x07, 0x04, 0x0a, 0x0a, 0x0a, 0x15, 0x12, 0x0d, 0x00 },   // 0x26, &
        { 0x07, 0x04, 0x04, 0x08, 0x00, 0x00, 0x00, 0x00, 0x00 },   // 0x27, '
        { 0x07, 0x02, 0x04, 0x08, 0x08, 0x08, 0x04, 0x02, 0x00 },   // 0x28, (
        { 0x07, 0x08, 0x04, 0x02, 0x02, 0x02, 0x04, 0x08, 0x00 },   // 0x29, )
        { 0x07, 0x04, 0x15, 0x0e, 0x1f, 0x0e, 0x15, 0x04, 0x00 },   // 0x2a, *
        { 0x07, 0x00, 0x04, 0x04, 0x1f, 0x04, 0x04, 0x00, 0x00 },   // 0x2b, +
        { 0x04, 0x00, 0x00, 0x00, 0x00, 0x00, 0x01, 0x01, 0x02 },   // 0x2c, ,
        { 0x07, 0x00, 0x00, 0x00, 0x1f, 0x00, 0x00, 0x00, 0x00 },   // 0x2d, -
        { 0x04, 0x00, 0x00, 0x00, 0x00, 0x00, 0x03, 0x03, 0x00 },   // 0x2e, .
        { 0x07, 0x01, 0x01, 0x02, 0x04, 0x08, 0x10, 0x10, 0x00 },   // 0x2f, /
        { 0x07, 0x0F, 0x09, 0x09, 0x09, 0x09, 0x09, 0x0F, 0x00 },   // 0x30, 0
        { 0x07, 0x02, 0x02, 0x02, 0x02, 0x02, 0x02, 0x02, 0x00 },   // 0x31, 1
        { 0x07, 0x0F, 0x01, 0x01, 0x0F, 0x08, 0x08, 0x0F, 0x00 },   // 0x32, 2
        { 0x07, 0x0F, 0x01, 0x01, 0x0F, 0x01, 0x01, 0x0F, 0x00 },   // 0x33, 3
        { 0x07, 0x09, 0x09, 0x09, 0x0F, 0x01, 0x01, 0x01, 0x00 },   // 0x34, 4
        { 0x07, 0x0F, 0x08, 0x08, 0x0F, 0x01, 0x01, 0x0F, 0x00 },   // 0x35, 5
        { 0x07, 0x0F, 0x08, 0x08, 0x0F, 0x09, 0x09, 0x0F, 0x00 },   // 0x36, 6
        { 0x07, 0x0F, 0x01, 0x01, 0x01, 0x01, 0x01, 0x01, 0x00 },   // 0x37, 7
        { 0x07, 0x0F, 0x09, 0x09, 0x0F, 0x09, 0x09, 0x0F, 0x00 },   // 0x38, 8
        { 0x07, 0x0F, 0x09, 0x09, 0x0F, 0x01, 0x01, 0x0F, 0x00 },   // 0x39, 9
        { 0x04, 0x00, 0x01, 0x01, 0x00, 0x01, 0x01, 0x00, 0x00 },   // 0x3a, :
        { 0x07, 0x00, 0x0c, 0x0c, 0x00, 0x0c, 0x04, 0x08, 0x00 },   // 0x3b, ;
        { 0x07, 0x02, 0x04, 0x08, 0x10, 0x08, 0x04, 0x02, 0x00 },   // 0x3c, <
        { 0x04, 0x00, 0x00, 0x00, 0x00, 0x00, 0x00, 0x00, 0x00 },   // 0x3d, =
        { 0x07, 0x08, 0x04, 0x02, 0x01, 0x02, 0x04, 0x08, 0x00 },   // 0x3e, >
        { 0x07, 0x0e, 0x11, 0x01, 0x02, 0x04, 0x00, 0x04, 0x00 },   // 0x3f, ?
        { 0x07, 0x0e, 0x11, 0x17, 0x15, 0x17, 0x10, 0x0f, 0x00 },   // 0x40, @
        { 0x07, 0x04, 0x0a, 0x11, 0x11, 0x1f, 0x11, 0x11, 0x00 },   // 0x41, A
        { 0x07, 0x1e, 0x11, 0x11, 0x1e, 0x11, 0x11, 0x1e, 0x00 },   // 0x42, B
        { 0x07, 0x0e, 0x11, 0x10, 0x10, 0x10, 0x11, 0x0e, 0x00 },   // 0x43, C
        { 0x07, 0x1E, 0x11, 0x11, 0x11, 0x11, 0x11, 0x1E, 0x00 },   // 0x44, D
        { 0x07, 0x1f, 0x10, 0x10, 0x1c, 0x10, 0x10, 0x1f, 0x00 },   // 0x45, E
        { 0x07, 0x1f, 0x10, 0x10, 0x1f, 0x10, 0x10, 0x10, 0x00 },   // 0x46, F
        { 0x07, 0x0e, 0x11, 0x10, 0x10, 0x13, 0x11, 0x0f, 0x00 },   // 0x37, G
        { 0x07, 0x11, 0x11, 0x11, 0x1f, 0x11, 0x11, 0x11, 0x00 },   // 0x48, H
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
        { 0x07, 0x0c, 0x12, 0x0c, 0x00, 0x00, 0x00, 0x00, 0x00 },   // 0x7e, degree
        { 0x07, 0x1f, 0x1f, 0x1f, 0x1f, 0x1f, 0x1f, 0x1f, 0x00 }    // 0x7f, DEL
};

// Font 5x8 in an 8x8 matrix, 0,0 is top right
unsigned short const font2[96][9] = { { 0x07, 0x00, 0x00, 0x00, 0x00, 0x00,
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
}
//**************************************************************************************************
bool autoConfig()
{
    WiFi.setAutoConnect(false);
    WiFi.setAutoReconnect(true);
    WiFi.setSleepMode(WIFI_NONE_SLEEP);    // keep the web UI/OTA responsive; the clock is mains-powered

    if (strlen(settings.ssid) > 0)
    {
        WiFi.persistent(false);   // settings are the source of truth, don't touch flash config
        Serial.printf("Connecting to SSID:%s PSW:%s\r\n", settings.ssid, passHidden(settings.pass));
        Serial.println("Scanning networks...");
        int n = WiFi.scanNetworks();
        Serial.printf("Found %d networks\r\n", n);
        bool found = false;
        for (int i = 0; i < n; i++)
        {
            Serial.printf("  %d: %s (%d dBm)\r\n", i, WiFi.SSID(i).c_str(), WiFi.RSSI(i));
            if (WiFi.SSID(i).equals(settings.ssid)) found = true;
        }
        Serial.printf("Target SSID %s: %s\r\n", settings.ssid, found ? "FOUND" : "NOT FOUND");

        WiFi.disconnect(false, false);   // stop any in-flight attempt, keep stored credentials
        delay(200);
        WiFi.mode(WIFI_STA);
        WiFi.begin(settings.ssid, settings.pass);   // credentials from settings
    }
    else
    {
        WiFi.persistent(true);    // smartConfig path relies on flash persistence
        Serial.println("No SSID in settings, using flash saved config");
        WiFi.mode(WIFI_STA);
        WiFi.begin();                               // connect to the saved WiFi by default
    }

    for (int i = 0; i < 10; i++)
    {
       char2Arr('W', 28, 0);
       char2Arr('i', 22, 0);
       char2Arr('-', 18, 0);
       char2Arr('F', 12, 0);
       char2Arr('i', 6, 0);

       refresh_display(); 
       
       if (WiFi.status() == WL_CONNECTED)
       {
          Serial.println("AutoConfig Success");
          Serial.printf("SSID:%s\r\n", WiFi.SSID().c_str());
           Serial.printf("PSW:%s\r\n", passHidden(WiFi.psk().c_str()));
          clear_Display();
          char2Arr('O', 25, 0);
          char2Arr('K', 19, 0);
          char2Arr('!', 12, 0);
          char2Arr('!', 6, 0);
          refresh_display(); 

          Serial.println("WiFi connected");
          Serial.println(WiFi.localIP());
          Serial.println("Starting UDP");
          udp.begin(localPort);
          Serial.print("Local port: ");
          Serial.println(udp.localPort());
          return true;
       }
       else{
          Serial.print("AutoConfig Waiting......");
          Serial.println(WiFi.status());
          delay(1000);
       }
    }
    clear_Display();
    char2Arr('E', 25, 0);
    char2Arr('r', 19, 0);
    char2Arr('r', 12, 0);
    char2Arr('!', 6, 0);
    refresh_display(); 
    delay(1000);
    Serial.println("AutoConfig Failed!" );
    return false;
}
//***************************Smart Config**********************************************************************
void smartConfig()
{
    int i = 0;
  
    WiFi.mode(WIFI_STA);
    Serial.println("\r\nWait for Smartconfig");
    WiFi.beginSmartConfig();
    for (i = 0; i < 30; i++)
    {
       Serial.print(".");
       if(WiFi.smartConfigDone())
       {
          clear_Display();
          char2Arr('O', 25, 0);
          char2Arr('K', 19, 0);
          char2Arr('!', 12, 0);
          char2Arr('!', 6, 0);
          refresh_display(); 
          Serial.println("SmartConfig Success");
          Serial.printf("SSID:%s\r\n", WiFi.SSID().c_str());
           Serial.printf("PSW:%s\r\n", passHidden(WiFi.psk().c_str()));
          WiFi.setAutoConnect(true);  // enable auto connect
          
          strncpy(settings.ssid, WiFi.SSID().c_str(), sizeof(settings.ssid) - 1);   // remember credentials in settings
          settings.ssid[sizeof(settings.ssid) - 1] = '\0';
          strncpy(settings.pass, WiFi.psk().c_str(), sizeof(settings.pass) - 1);
          settings.pass[sizeof(settings.pass) - 1] = '\0';
          settings_save();
          
          Serial.println("WiFi connected");
          Serial.println(WiFi.localIP());
          Serial.println("Starting UDP");
          udp.begin(localPort);
          Serial.print("Local port: ");
          Serial.println(udp.localPort());
          delay(1000); 
          ESP.restart();
          break;
       }
       clear_Display();
       char2Arr('S', 29, 0);// show "S-con" while entering smart config mode
       char2Arr('-', 23, -1);
       char2Arr('c', 17, 0);
       char2Arr('o', 12, 0);
       char2Arr('n', 6, 0);
       refresh_display(); 
       delay(1000);
    }
    if (i > 28)
    {
       clear_Display();
       char2Arr('R', 25, 0);
       char2Arr('T', 19, 0);
       char2Arr('C', 12, 0);
       char2Arr('!', 6, 0);
       refresh_display(); 
       delay(1000);
       Serial.println("SmartConfig Failed!" );
       Serial.println("Clock uses RTC!" );
       WiFi.stopSmartConfig();   // release the radio so the fallback softAP can start
    }
}
//**************************************************************************************************
//***************************Settings Storage (EEPROM)**********************************************************************
void settings_save()
{
    EEPROM.put(0, settings);
    EEPROM.commit();
}
//**************************************************************************************************
void settings_load()
{
    EEPROM.begin(sizeof(ClockSettings) + 8);
    EEPROM.get(0, settings);
    if (settings.magic != 0xA5A5A5A5 || settings.dstRule > 3)   // dstRule > 3 = settings saved by an older firmware
    {
        settings = settings_defaults;
        settings_save();
    }
    bool repaired = false;
    if (settings.colonAnim > 5) { settings.colonAnim = 0; repaired = true; }   // new fields: 0xFF from older firmware = off
    if (settings.orient == 0 || settings.orient > 2) { settings.orient = 1; repaired = true; }   // Auto removed: board has no orientation switch
    if (settings.ntpInterval > 720) { settings.ntpInterval = 0; repaired = true; }   // field added later / garbage from old EEPROM -> off
    if (settings.weather > 1) { settings.weather = 0; repaired = true; }   // new fields: 0xFF from older firmware = off
    if (settings.weatherInterval > 240 || settings.weatherInterval == 0) { settings.weatherInterval = 30; repaired = true; }
    if (settings.weatherSpeed == 4) { settings.weatherSpeed = 3; repaired = true; }   // VFast removed -> Fast
    else if (settings.weatherSpeed < 1 || settings.weatherSpeed > 3) { settings.weatherSpeed = 2; repaired = true; }   // new field / garbage from old EEPROM -> normal
    if (settings.scrollDateInt < 1 || settings.scrollDateInt > 120) { settings.scrollDateInt = 1; repaired = true; }   // new field -> every minute
    if (settings.rainWarn > 1) { settings.rainWarn = 1; repaired = true; }   // new field / garbage from old EEPROM -> on
    if (settings.heatWarn > 1) { settings.heatWarn = 1; repaired = true; }   // new field / garbage from old EEPROM -> on
    if (settings.rainThresh < 1 || settings.rainThresh > 25) { settings.rainThresh = 2; repaired = true; }   // legacy field -> 2mm
    if (settings.heatThresh < 20 || settings.heatThresh > 50) { settings.heatThresh = 31; repaired = true; }   // legacy field -> 31C
    if (settings.threshFormat != 0xA55A)   // settings saved by v5.7 or older: copy whole-number thresholds
    {
        settings.rainThresh10 = (uint16_t) settings.rainThresh * 10;
        settings.heatThresh10 = (uint16_t) settings.heatThresh * 10;
        settings.threshFormat = 0xA55A;
        repaired = true;
    }
    if (settings.rainThresh10 < 1 || settings.rainThresh10 > 250) { settings.rainThresh10 = 20; repaired = true; }   // 0.1..25.0 mm
    if (settings.heatThresh10 < 200 || settings.heatThresh10 > 500) { settings.heatThresh10 = 310; repaired = true; }   // 20.0..50.0 C
    uint8_t rainWhole = (uint8_t) constrain((settings.rainThresh10 + 5) / 10, 1, 25);
    uint8_t heatWhole = (uint8_t) constrain((settings.heatThresh10 + 5) / 10, 20, 50);
    if (settings.rainThresh != rainWhole) { settings.rainThresh = rainWhole; repaired = true; }
    if (settings.heatThresh != heatWhole) { settings.heatThresh = heatWhole; repaired = true; }
    if (settings.birthdayFormat != 0xB17D)   // settings saved by older firmware
    {
        memset(settings.birthdays, 0, sizeof(settings.birthdays));
        settings.birthdayEnabled = 1;
        settings.birthdayFreq = 60;
        settings.birthdayAnim = 1;
        settings.birthdayFormat = 0xB17D;
        repaired = true;
    }
    if (settings.birthdayEnabled > 1) { settings.birthdayEnabled = 1; repaired = true; }
    if (settings.birthdayFreq != 0 && settings.birthdayFreq != 15 && settings.birthdayFreq != 30
        && settings.birthdayFreq != 60 && settings.birthdayFreq != 120 && settings.birthdayFreq != 240)
    { settings.birthdayFreq = 60; repaired = true; }
    if (settings.birthdayAnim > 1) { settings.birthdayAnim = 1; repaired = true; }
    for (uint8_t i = 0; i < BIRTHDAY_MAX; i++)
    {
        settings.birthdays[i].name[sizeof(settings.birthdays[i].name) - 1] = '\0';
        for (unsigned j = 0; j < sizeof(settings.birthdays[i].name); j++)
            if ((unsigned char) settings.birthdays[i].name[j] > 0x7E)
            {
                settings.birthdays[i].name[j] = '\0';
                repaired = true;
                break;
            }
        if (settings.birthdays[i].day == 0 && settings.birthdays[i].month == 0)
            continue;
        if (settings.birthdays[i].day < 1 || settings.birthdays[i].day > 31
            || settings.birthdays[i].month < 1 || settings.birthdays[i].month > 12)
        {
            settings.birthdays[i].day = 0;
            settings.birthdays[i].month = 0;
            settings.birthdays[i].year = 0;
            repaired = true;
        }
        else if (settings.birthdays[i].year != 0
                 && (settings.birthdays[i].year < 1900 || settings.birthdays[i].year > 2100))
        {
            settings.birthdays[i].year = 0;
            repaired = true;
        }
    }
    if (settings.greetingFormat != 0xB17E)   // settings saved before holiday frequency existed
    {
        settings.holidayFreq = 0;
        settings.greetingFormat = 0xB17E;
        repaired = true;
    }
    if (settings.detailFormat != 0xDE7A)
    {
        settings.weatherDetails = 1;
        settings.detailFormat = 0xDE7A;
        repaired = true;
    }
    if (settings.weatherDetails > 1) { settings.weatherDetails = 1; repaired = true; }
    if (settings.textFxFormat != 0xEFF5)
    {
        if (settings.textEffect == 2 || settings.textEffect == 3)
            settings.textEffect = 0;   // removed Slide Down/Up
        settings.textFxFormat = 0xEFF5;
        repaired = true;
    }
    if (settings.textEffect > 4) { settings.textEffect = 0; repaired = true; }
    if (settings.dateSpeedFormat != 0xDA7E)
    {
        settings.dateSpeed = 2;
        settings.dateSpeedFormat = 0xDA7E;
        repaired = true;
    }
    if (settings.dateSpeed < 1 || settings.dateSpeed > 3) { settings.dateSpeed = 2; repaired = true; }
    if (settings.transitionFormat != 0xD158)
    {
        // 0xD157 was the v5.5.x marker; value 12 was Random there.
        if (settings.transitionFormat == 0xD157 && settings.displayTransition == 12)
            settings.displayTransition = TRANSITION_RANDOM;
        settings.transitionFormat = 0xD158;
        repaired = true;
    }
    if (settings.displayTransition > TRANSITION_RANDOM) { settings.displayTransition = TRANSITION_PACMAN; repaired = true; }
    if (settings.displayTransition == TRANSITION_BREAKOUT)
    {
        settings.displayTransition = TRANSITION_SPACE;   // Breakout was removed
        repaired = true;
    }
    if (settings.apPassFormat != 0xAB12)
    {
        strncpy(settings.apPass, "12345678", sizeof(settings.apPass) - 1);
        settings.apPass[sizeof(settings.apPass) - 1] = 0;
        settings.apPassFormat = 0xAB12;
        repaired = true;
    }
    settings.apPass[sizeof(settings.apPass) - 1] = 0;
    if (strlen(settings.apPass) < 8)
    {
        strncpy(settings.apPass, "12345678", sizeof(settings.apPass) - 1);
        settings.apPass[sizeof(settings.apPass) - 1] = 0;
        repaired = true;
    }
    if (settings.holidayFreq != 0 && settings.holidayFreq != 15 && settings.holidayFreq != 30
        && settings.holidayFreq != 60 && settings.holidayFreq != 120 && settings.holidayFreq != 240)
    { settings.holidayFreq = 0; repaired = true; }
    if (settings.digitAnim > 5) { settings.digitAnim = 1; repaired = true; }   // new field / garbage from old EEPROM -> roll
    if (settings.weatherCityShow > 1) { settings.weatherCityShow = 1; repaired = true; }   // new field / garbage from old EEPROM -> show city
    if (settings.warnAnim > 1) { settings.warnAnim = 1; repaired = true; }   // new field / garbage from old EEPROM -> animation on
    if (settings.shabbat > 1) { settings.shabbat = 1; repaired = true; }   // new field / garbage from old EEPROM -> on
    if (settings.shabbatLead < 10 || settings.shabbatLead > 240) { settings.shabbatLead = 60; repaired = true; }   // new field -> 60 min
    if (settings.shabbatFreq != 5 && settings.shabbatFreq != 10 && settings.shabbatFreq != 15
        && settings.shabbatFreq != 20 && settings.shabbatFreq != 30 && settings.shabbatFreq != 60)
    { settings.shabbatFreq = 10; repaired = true; }
    if (settings.shabbatAnim > 1) { settings.shabbatAnim = 1; repaired = true; }
    if (settings.holidayGreetings > 1) { settings.holidayGreetings = 1; repaired = true; }   // new field -> on
    settings.weatherCity[sizeof(settings.weatherCity) - 1] = '\0';
    for (unsigned i = 0; i < sizeof(settings.weatherCity); i++)   // blank EEPROM (0xFF) from older firmware -> empty
        if ((unsigned char) settings.weatherCity[i] > 0x7E)
        {
            settings.weatherCity[i] = '\0';
            repaired = true;
            break;
        }
    settings.webPass[sizeof(settings.webPass) - 1] = '\0';
    for (unsigned i = 0; i < sizeof(settings.webPass); i++)   // blank EEPROM (0xFF) from older firmware -> no auth
        if ((unsigned char) settings.webPass[i] > 0x7E)
        {
            settings.webPass[i] = '\0';
            repaired = true;
            break;
        }
    if (repaired)
        settings_save();   // persist the corrected fields so they don't need repairing on every boot
}
//**************************************************************************************************
bool parseBirthdayDate(const String& s, uint8_t& day, uint8_t& month, uint16_t& year)
{
    String t = s;
    t.trim();
    if (t.length() == 0)
    {
        day = 0;
        month = 0;
        year = 0;
        return true;
    }
    int p1 = t.indexOf('/');
    int p2 = (p1 >= 0) ? t.indexOf('/', p1 + 1) : -1;
    if (p1 < 0 || p2 < 0) return false;
    int d = t.substring(0, p1).toInt();
    int m = t.substring(p1 + 1, p2).toInt();
    int y = t.substring(p2 + 1).toInt();
    if (d < 1 || d > 31 || m < 1 || m > 12) return false;
    if (y != 0 && (y < 1900 || y > 2100)) return false;
    day = (uint8_t) d;
    month = (uint8_t) m;
    year = (uint16_t) y;
    return true;
}
//**************************************************************************************************
String birthdayDateStr(const BirthdayEntry& b)
{
    if (b.day == 0 || b.month == 0) return "";
    char s[16];
    if (b.year)
        snprintf(s, sizeof s, "%02u/%02u/%04u", b.day, b.month, b.year);
    else
        snprintf(s, sizeof s, "%02u/%02u", b.day, b.month);
    return String(s);
}
//**************************************************************************************************
//***************************Web Settings Page**********************************************************************
ESP8266WebServer server(80);
unsigned long otaRebootAt = 0;          // >0 while waiting to reboot after a successful update
bool otaUploadStarted = false;
bool otaUploadSuccess = false;
char otaUploadError[96] = "";
Ticker otaWatchdog;
volatile bool otaWatchdogActive = false;
volatile unsigned long otaLastProgressMs = 0;

void otaWatchdogTick()   // reset if the upload parser waits forever on a half-open socket
{
    if (otaWatchdogActive && (millis() - otaLastProgressMs > 45000UL))
        ESP.restart();
}
//**************************************************************************************************
bool webAuthOk()   // optional HTTP Basic auth: enabled only when a web password is configured
{
    if (settings.webPass[0] == 0) return true;
    return server.authenticate("admin", settings.webPass);
}
//**************************************************************************************************
void startMsg(const char* text, uint8_t step = 2);   // forward decl, defined below
void max7219_set_brightness(unsigned short br);
void startMsgEatTransition(bool pending, uint8_t forcedType = 0xFF);
bool displayHasPixels();
void rtc_clearOsf();
float rtc_temp();
bool rtc_osf();
int8_t rtc_aging();
void serviceClockDisplayDuringWeb();
void startAP()   // start fallback AP so the settings page stays reachable without router WiFi
{
    if (apActive) return;
    WiFi.setAutoReconnect(false);   // stop the SDK's background retry loop
    WiFi.mode(WIFI_OFF);            // clean radio state (also clears any SmartConfig session)
    delay(300);
    WiFi.mode(WIFI_AP_STA);         // keep the station interface available for WiFi scanning
    const char* apPass = (strlen(settings.apPass) >= 8) ? settings.apPass : "12345678";
    bool ok = WiFi.softAP("MatrixClock-Setup", apPass);
    if (!ok)
    {
        delay(400);
        ok = WiFi.softAP("MatrixClock-Setup", apPass);
    }
    if (!ok)
    {
        Serial.println("AP start FAILED (softAP returned false)");
        WiFi.mode(WIFI_STA);
        WiFi.setAutoReconnect(true);
        return;    }
    apActive = true;
    apMsgUntil = millis() + 30000UL;   // keep showing the setup hint for 30 seconds
    startMsg("SETUP MODE AP 192.168.4.1");
    logLine("AP started: MatrixClock-Setup / http://%s",
            WiFi.softAPIP().toString().c_str());
}
//**************************************************************************************************
void stopAP()    // stop fallback AP once the router connection works again
{
    if (!apActive) return;
    apActive = false;
    WiFi.setAutoReconnect(true);    // normal reconnect behavior once the router is back
    // Shut the softAP down a few seconds later: switching the opmode in the same
    // instant the station connection completes can crash the SDK (observed: reset
    // right after "WiFi connected" with no "AP stopped" printed).
    apShutdownPending = true;
    apShutdownSince = millis();
    logLine("AP stop scheduled");
}
//**************************************************************************************************
void enterAPUpdateMode()   // switch to the setup AP so a weak router link can't break the upload
{
    apUpdateMode = true;
    apUpdateSince = millis();
    startAP();   // robust AP-only start with retry and softAP result check
    if (!apActive)
    {
        Serial.println("AP update mode failed, rebooting");
        delay(1500);
        ESP.restart();
        return;
    }
    apMsgUntil = millis() + 3600000UL;   // keep the hint message for an hour
    server.close();
    server.begin();   // rebind the web server to the AP interface
    startMsg("AP UPDATE 192.168.4.1");
    logLine("AP update mode: IP=%s", WiFi.softAPIP().toString().c_str());
}
//**************************************************************************************************
void startMsgNow(const char* text, uint8_t step, bool useTransition = true)
{
    strncpy(msg, text, sizeof(msg) - 1);
    msg[sizeof(msg) - 1] = 0;
    msgStep = step;
    if (useTransition && settings.displayTransition != TRANSITION_OFF && displayHasPixels())
        startMsgEatTransition(true);
    else
    {
        msgEatActive = false;
        msgEatPending = false;
        showMsg = true;
    }
    max7219_set_brightness(settings.brightness);
    z_PosX = 0;
    d_PosX = -8;
}

void startNextQueuedMsg()
{
    if (msgQueueCount == 0) return;
    strncpy(msg, msgQueue[0], sizeof(msg) - 1);
    msg[sizeof(msg) - 1] = 0;
    msgStep = msgQueueStep[0];
    for (uint8_t i = 1; i < msgQueueCount; i++)
    {
        strncpy(msgQueue[i - 1], msgQueue[i], sizeof(msgQueue[i]) - 1);
        msgQueueStep[i - 1] = msgQueueStep[i];
    }
    msgQueueCount--;
    showMsg = true;
    max7219_set_brightness(settings.brightness);
    z_PosX = 0;
    d_PosX = -8;
}

void startMsg(const char* text, uint8_t step)   // scroll a message; queue up to 3 so weather/Shabbat are not lost
{
    if (!showMsg && msgQueueCount == 0 && !msgEatActive)
    {
        startMsgNow(text, step);
        return;
    }
    if (msgQueueCount >= MSG_QUEUE_SIZE)   // drop the oldest queued message
    {
        for (uint8_t i = 1; i < MSG_QUEUE_SIZE; i++)
        {
            strncpy(msgQueue[i - 1], msgQueue[i], sizeof(msgQueue[i]) - 1);
            msgQueueStep[i - 1] = msgQueueStep[i];
        }
        msgQueueCount = MSG_QUEUE_SIZE - 1;
    }
    strncpy(msgQueue[msgQueueCount], text, sizeof(msgQueue[msgQueueCount]) - 1);
    msgQueue[msgQueueCount][sizeof(msgQueue[msgQueueCount]) - 1] = 0;
    msgQueueStep[msgQueueCount] = step;
    msgQueueCount++;
}
//**************************************************************************************************
void startNtpMessage(tm* tt)   // show the ping correction and the synced time
{
    if (tt == NULL)
    {
        startMsg("NTP SYNC FAILED");
        return;
    }
    char b[80];
    snprintf(b, sizeof b, "NTP OK!! PING %luMS ADJ %luMS %02d:%02d",
             ntpLastRttMs, ntpLastTransitMs, tt->tm_hour, tt->tm_min);
    startMsg(b);
}
//**************************************************************************************************
String htmlEscape(const char* s)   // escape special chars so saved values can't break the HTML form
{
    String out;
    for (const char* p = s; *p; p++)
    {
        if (*p == '&') out += "&amp;";
        else if (*p == '<') out += "&lt;";
        else if (*p == '>') out += "&gt;";
        else if (*p == '"') out += "&quot;";
        else out += *p;
    }
    return out;
}
//**************************************************************************************************
String jsonEsc(const char* s)   // escape special chars so saved values can't break the /v JSON
{
    String out;
    for (const char* p = s; *p; p++)
    {
        if (*p == '"') out += "\\\"";
        else if (*p == '\\') out += "\\\\";
        else out += *p;
    }
    return out;
}
//**************************************************************************************************
uint32_t fnv1aHash(const char* data, size_t len, uint32_t h)
{
    while (len--)
    {
        h ^= (uint8_t) *data++;
        h *= 16777619UL;
    }
    return h;
}
//**************************************************************************************************
String tenthsStr(uint16_t v)   // 12 -> "1.2" (used by the settings page and logs)
{
    char b[10];
    snprintf(b, sizeof b, "%u.%u", (unsigned) (v / 10), (unsigned) (v % 10));
    return String(b);
}
//**************************************************************************************************
#define WEB_SEND_TIMEOUT_MS 45000UL   // hard cap on one response, so a stalled browser cannot freeze the clock forever

void sendChunked(int code, const char* contentType, const String& body)
    // ESP8266 lwIP can silently drop a TCP segment when a response is handed to the socket as one
    // large write() and never retransmit it -- which is why the settings page used to need several
    // reloads to fully load. Sending the same bytes as a series of explicit writes (each well under
    // one TCP segment) with a yield() between them avoids that failure mode.
    // The writes are zero-copy: they point straight into the existing body buffer. The previous
    // version built a fresh substring() String per chunk, and when that allocation failed under
    // heap fragmentation it silently sent nothing while the loop still advanced -- leaving holes
    // in the middle of the page (the "settings page sometimes incomplete" bug).
{
    const size_t CHUNK = 1024;
    const char* p = body.c_str();
    size_t total = body.length();
    server.client().setNoDelay(true);   // small chunks + Nagle = one delayed ACK per chunk
    server.setContentLength(total);
    server.send(code, contentType, "");
    unsigned long started = millis();
    size_t sentLen = 0;
    while (sentLen < total)
    {
        // Serving an HTTP response is real work, not a hung main loop. Keep the 30 s
        // loop watchdog from resetting the clock while a large page is going out.
        loopHeartbeatMs = millis();
        serviceClockDisplayDuringWeb();
        if (millis() - started > WEB_SEND_TIMEOUT_MS) { server.client().stop(); return; }
        size_t n = min(CHUNK, total - sentLen);
        size_t written = server.client().write(p + sentLen, n);
        if (written == 0)   // socket stalled or gone: back off and retry the same bytes
        {
            if (!server.client().connected()) return;   // browser vanished, nothing more to send
            if (millis() - started > WEB_SEND_TIMEOUT_MS) { server.client().stop(); return; }   // never block the whole clock on one page
            delay(2);
            continue;
        }
        sentLen += written;
        yield();
    }
}
//**************************************************************************************************
void sendChunked_P(int code, const char* contentType, const char* body, size_t total)
    // Same as sendChunked(), but the body stays in flash (PROGMEM) instead of using heap.
{
    const size_t CHUNK = 1024;
    server.client().setNoDelay(true);   // small chunks + Nagle = one delayed ACK per chunk
    server.setContentLength(total);
    server.send(code, contentType, "");
    unsigned long started = millis();
    size_t sentLen = 0;
    static char buf[CHUNK];   // static: keep the larger buffer off the 4 KB loop stack
    while (sentLen < total)
    {
        loopHeartbeatMs = millis();
        serviceClockDisplayDuringWeb();
        if (millis() - started > WEB_SEND_TIMEOUT_MS) { server.client().stop(); return; }
        size_t n = min(CHUNK, total - sentLen);
        memcpy_P(buf, body + sentLen, n);
        size_t offset = 0;
        while (offset < n)
        {
            size_t written = server.client().write((const uint8_t*) (buf + offset), n - offset);
            if (written == 0)
            {
                if (!server.client().connected()) return;
                if (millis() - started > WEB_SEND_TIMEOUT_MS) { server.client().stop(); return; }
                delay(2);
                continue;
            }
            offset += written;
        }
        sentLen += n;
        yield();
    }
}

void sendChunked_P(int code, const char* contentType, const char* body)
{
    sendChunked_P(code, contentType, body, strlen_P(body));
}
//**************************************************************************************************

bool clientAcceptsGzip()
{
    return server.header("Accept-Encoding").indexOf("gzip") >= 0;
}

void sendWebAsset(const char* etag, const char* contentType, const char* raw, size_t rawLen,
                  const uint8_t* gz, size_t gzLen, size_t expectedRawLen)
{
    if (server.header("If-None-Match") == etag)
    {
        server.sendHeader("Cache-Control", "private, no-cache, must-revalidate");
        server.sendHeader("ETag", etag);
        server.sendHeader("Vary", "Accept-Encoding");
        server.keepAlive(false);
        server.send(304, "text/plain", "");
        return;
    }

    server.sendHeader("Cache-Control", "private, no-cache, must-revalidate");
    server.sendHeader("ETag", etag);
    server.sendHeader("Vary", "Accept-Encoding");
    bool useGzip = gzLen > 0 && rawLen == expectedRawLen && clientAcceptsGzip();
    if (useGzip)
    {
        server.sendHeader("Content-Encoding", "gzip");
        sendChunked_P(200, contentType, (const char*) gz, gzLen);
    }
    else
    {
        sendChunked_P(200, contentType, raw, rawLen);
    }
}

void handleRoot()
{
    // Settings page shell. CSS and JS are separate cacheable assets, so a repeat
    // visit only revalidates this small HTML file instead of downloading ~28 KB.
    if (!webAuthOk()) { server.requestAuthentication(); return; }
    static const char PAGE_ETAG[] = "\"" FIRMWARE_VERSION " " __DATE__ " " __TIME__ "\"";
    server.keepAlive(false);   // free the socket after the page; avoids ESP8266 keep-alive stalls
    sendWebAsset(PAGE_ETAG, "text/html", ROOT_PAGE, strlen_P(ROOT_PAGE),
                 WEB_HTML_GZ, WEB_HTML_GZ_LEN, WEB_HTML_RAW_LEN);
}

void handleCss()
{
    if (!webAuthOk()) { server.requestAuthentication(); return; }
    static const char CSS_ETAG[] = "\"" FIRMWARE_VERSION " css " __DATE__ " " __TIME__ "\"";
    server.keepAlive(false);
    sendWebAsset(CSS_ETAG, "text/css", APP_CSS, strlen_P(APP_CSS),
                 WEB_CSS_GZ, WEB_CSS_GZ_LEN, WEB_CSS_RAW_LEN);
}

void handleJs()
{
    if (!webAuthOk()) { server.requestAuthentication(); return; }
    static const char JS_ETAG[] = "\"" FIRMWARE_VERSION " js " __DATE__ " " __TIME__ "\"";
    server.keepAlive(false);
    sendWebAsset(JS_ETAG, "application/javascript", APP_JS, strlen_P(APP_JS),
                 WEB_JS_GZ, WEB_JS_GZ_LEN, WEB_JS_RAW_LEN);
}
//**************************************************************************************************
void handleValues()
{
    if (!webAuthOk()) { server.requestAuthentication(); return; }
    server.keepAlive(false);
    String j;
    j.reserve(5000);
    j = "{\"f\":[";
    j += "[\"SSID\",\"ssid\",null,\"" + jsonEsc(settings.ssid) + "\"],";
    j += "[\"WiFi Password\",\"pass\",null,\"\"],";   // never return the saved password; leave blank to keep it
    j += "[\"Web Login Password\",\"webPass\",null,\"" + String(settings.webPass[0] ? "********" : "") + "\"],";
    j += "[\"Setup AP Password\",\"apPass\",null,\"\"] ,";
    j += "[\"NTP Server\",\"ntp\",null,\"" + jsonEsc(settings.ntpServer) + "\"],";
    j += "[\"Time Zone\",\"tz\",null,\"" + String(settings.tzOffset) + "\"],";
    j += "[\"Daylight Saving Time\",\"dst\",[[\"0\",\"Off\"],[\"1\",\"IL\"],[\"2\",\"EU\"],[\"3\",\"US\"]],\"" + String(settings.dstRule) + "\"],";
    j += "[\"Brightness\",\"bright\",null,\"" + String(settings.brightness) + "\"],";
    j += "[\"Orientation\",\"orient\",[[\"1\",\"Normal\"],[\"2\",\"Flip\"]],\"" + String(settings.orient) + "\"],";
    j += "[\"Scroll Date\",\"scrollDate\",[[\"0\",\"Off\"],[\"1\",\"On\"]],\"" + String(settings.scrollDate) + "\"],";
    j += "[\"Date Interval (min)\",\"scrollDateInt\",null,\"" + String(settings.scrollDateInt) + "\"],";
    j += "[\"Date Scroll Speed\",\"dateSpeed\",[[\"1\",\"Slow\"],[\"2\",\"Normal\"],[\"3\",\"Fast\"]],\"" + String(settings.dateSpeed) + "\"],";
    j += "[\"Digit Animation Direction\",\"scrollDir\",[[\"0\",\"Up-Down\"],[\"1\",\"Down-Up\"]],\"" + String(settings.scrollDir) + "\"],";
    j += "[\"Colon Animation\",\"colonAnim\",[[\"0\",\"Solid\"],[\"1\",\"Blink\"],[\"2\",\"Slow\"],[\"3\",\"Dbl\"],[\"4\",\"Alt\"],[\"5\",\"Center Out\"]],\"" + String(settings.colonAnim) + "\"],";
    j += "[\"Digit Animation\",\"digitAnim\",[[\"0\",\"Off\"],[\"1\",\"Roll\"],[\"2\",\"Flip\"],[\"3\",\"Wipe\"],[\"4\",\"Fade\"],[\"5\",\"Drop\"]],\"" + String(settings.digitAnim) + "\"],";
    j += "[\"Message Effect\",\"textEffect\",[[\"0\",\"Scroll\"],[\"1\",\"Fade\"],[\"4\",\"Blink\"]],\"" + String(settings.textEffect) + "\"],";
    j += "[\"Display Transition\",\"displayTransition\",[[\"0\",\"Off\"],[\"1\",\"Pac-Man\"],[\"2\",\"Wipe\"],[\"3\",\"Dissolve\"],[\"4\",\"Blinds\"],[\"5\",\"Checkerboard\"],[\"6\",\"Melt\"],[\"7\",\"Matrix Rain\"],[\"8\",\"Slide\"],[\"9\",\"Sparkle\"],[\"10\",\"Snake\"],[\"11\",\"Barn Door\"],[\"13\",\"Space Invaders\"],[\"14\",\"Tetris\"],[\"15\",\"Random\"]],\"" + String(settings.displayTransition) + "\"],";
    j += "[\"NTP Resync\",\"resync\",[[\"0\",\"Off\"],[\"1\",\"On\"]],\"" + String(settings.resync) + "\"],";
    j += "[\"Resync Hour\",\"resyncHour\",null,\"" + String(settings.resyncHour) + "\"],";
    j += "[\"Resync Minute\",\"resyncMin\",null,\"" + String(settings.resyncMin) + "\"],";
    j += "[\"NTP Resync Interval (min)\",\"ntpInterval\",null,\"" + String(settings.ntpInterval) + "\"],";
    j += "[\"Weather Messages (warnings independent)\",\"weather\",[[\"0\",\"Off\"],[\"1\",\"On\"]],\"" + String(settings.weather) + "\"],";
    j += "[\"Weather City\",\"weatherCity\",null,\"" + jsonEsc(settings.weatherCity) + "\"],";
    j += "[\"Show Weather City\",\"weatherCityShow\",[[\"0\",\"Off\"],[\"1\",\"On\"]],\"" + String(settings.weatherCityShow) + "\"],";
    j += "[\"Weather Interval (min)\",\"weatherInterval\",null,\"" + String(settings.weatherInterval) + "\"],";
    j += "[\"Weather Speed\",\"weatherSpeed\",[[\"1\",\"Slow\"],[\"2\",\"Normal\"],[\"3\",\"Fast\"]],\"" + String(settings.weatherSpeed) + "\"],";
    j += "[\"Weather Details\",\"weatherDetails\",[[\"0\",\"Off\"],[\"1\",\"On\"]],\"" + String(settings.weatherDetails) + "\"],";
    j += "[\"Rain Warning\",\"rainWarn\",[[\"0\",\"Off\"],[\"1\",\"On\"]],\"" + String(settings.rainWarn) + "\"],";
    j += "[\"Rain Threshold (mm/h, e.g. 1.2)\",\"rainThresh\",null,\"" + tenthsStr(settings.rainThresh10) + "\"],";
    j += "[\"Heat Warning\",\"heatWarn\",[[\"0\",\"Off\"],[\"1\",\"On\"]],\"" + String(settings.heatWarn) + "\"],";
    j += "[\"Heat Threshold (°C, e.g. 35.5)\",\"heatThresh\",null,\"" + tenthsStr(settings.heatThresh10) + "\"],";
    j += "[\"Warning Animation\",\"warnAnim\",[[\"0\",\"Off\"],[\"1\",\"On\"]],\"" + String(settings.warnAnim) + "\"],";
    j += "[\"Shabbat Times\",\"shabbat\",[[\"0\",\"Off\"],[\"1\",\"On\"]],\"" + String(settings.shabbat) + "\"],";
    j += "[\"Shabbat Message Frequency\",\"shabbatFreq\",[[\"5\",\"5 min\"],[\"10\",\"10 min\"],[\"15\",\"15 min\"],[\"20\",\"20 min\"],[\"30\",\"30 min\"],[\"60\",\"60 min\"]],\"" + String(settings.shabbatFreq) + "\"],";
    j += "[\"Shabbat Lead (min)\",\"shabbatLead\",[[\"10\",\"10 min\"],[\"15\",\"15 min\"],[\"20\",\"20 min\"],[\"30\",\"30 min\"],[\"45\",\"45 min\"],[\"60\",\"1 hour\"],[\"90\",\"1.5 h\"],[\"120\",\"2 h\"],[\"180\",\"3 h\"],[\"240\",\"4 h\"]],\"" + String(settings.shabbatLead) + "\"],";
    j += "[\"Shabbat Animation\",\"shabbatAnim\",[[\"0\",\"Off\"],[\"1\",\"On\"]],\"" + String(settings.shabbatAnim) + "\"],";
    j += "[\"Holiday Greetings\",\"holidayGreetings\",[[\"0\",\"Off\"],[\"1\",\"On\"]],\"" + String(settings.holidayGreetings) + "\"],";
    j += "[\"Holiday Message Frequency\",\"holidayFreq\",[[\"0\",\"Once/day\"],[\"15\",\"15 min\"],[\"30\",\"30 min\"],[\"60\",\"1 hour\"],[\"120\",\"2 hours\"],[\"240\",\"4 hours\"]],\"" + String(settings.holidayFreq) + "\"],";
    j += "[\"Birthday Greetings\",\"birthdayEnabled\",[[\"0\",\"Off\"],[\"1\",\"On\"]],\"" + String(settings.birthdayEnabled) + "\"],";
    j += "[\"Birthday Message Frequency\",\"birthdayFreq\",[[\"0\",\"Once/day\"],[\"15\",\"15 min\"],[\"30\",\"30 min\"],[\"60\",\"1 hour\"],[\"120\",\"2 hours\"],[\"240\",\"4 hours\"]],\"" + String(settings.birthdayFreq) + "\"],";
    j += "[\"Birthday Animation\",\"birthdayAnim\",[[\"0\",\"Off\"],[\"1\",\"On\"]],\"" + String(settings.birthdayAnim) + "\"],";
    for (uint8_t i = 0; i < BIRTHDAY_MAX; i++)
    {
        char label[24], key[16];
        snprintf(label, sizeof label, "Birthday %u", (unsigned) (i + 1));
        snprintf(key, sizeof key, "bday%u", (unsigned) (i + 1));
        j += "[\"" + String(label) + "\",\"" + key + "\",\"birthday\",\""
             + jsonEsc(settings.birthdays[i].name) + "|" + birthdayDateStr(settings.birthdays[i]) + "\"]";
        if (i + 1 < BIRTHDAY_MAX) j += ",";
    }
    j += "]}";
    // Hash the exact JSON that will be sent. This makes /v cacheable without a
    // separate revision counter: any settings change produces a new ETag, and a
    // reboot cannot collide with an older cached value because the JSON itself
    // is hashed.
    uint32_t hash = fnv1aHash(FIRMWARE_VERSION, strlen(FIRMWARE_VERSION), 2166136261UL);
    hash = fnv1aHash(j.c_str(), j.length(), hash);
    char etag[16];
    snprintf(etag, sizeof etag, "\"%08lx\"", (unsigned long) hash);
    if (server.header("If-None-Match") == etag)
    {
        server.sendHeader("Cache-Control", "private, no-cache, must-revalidate");
        server.sendHeader("ETag", etag);
        server.send(304, "text/plain", "");
        return;
    }
    server.sendHeader("Cache-Control", "private, no-cache, must-revalidate");
    server.sendHeader("ETag", etag);
    sendChunked(200, "application/json", j);
}
//**************************************************************************************************
void handleWeatherPage()
{
    if (!webAuthOk()) { server.requestAuthentication(); return; }
    server.keepAlive(false);

    if (server.arg("format") == "json")
    {
        bool dataForCity = weatherDataValid && strcmp(weatherDataCity, settings.weatherCity) == 0;
        bool fresh = dataForCity && weatherDataFresh();
        bool warning = fresh && settings.rainWarn && weatherRainLatched;
        unsigned long omAge = dataForCity ? (millis() - weatherUpdatedMs) / 1000UL : 0;
        String j;
        j.reserve(520);
        j = "{\"ok\":1,\"city\":\"" + jsonEsc(settings.weatherCity) + "\"";
        j += ",\"threshold\":" + String(settings.rainThresh10 / 10.0, 1);
        j += ",\"rainWarn\":" + String(settings.rainWarn);
        j += ",\"warning\":" + String(warning ? 1 : 0);
        j += ",\"omValid\":" + String(dataForCity ? 1 : 0);
        j += ",\"omStale\":" + String((dataForCity && !fresh) ? 1 : 0);
        j += ",\"omNow\":" + String(weatherPrecipRate, 1);
        j += ",\"omPeak\":" + String(weatherRainPeak, 1);
        j += ",\"omProb\":" + String(weatherPrecipProb);
        j += ",\"om1h\":" + String(weatherRain1h, 2);
        j += ",\"om2h\":" + String(weatherRain2h, 2);
        j += ",\"omCodeRain\":" + String(weatherRainCodeSoon ? 1 : 0);
        j += ",\"omTemp\":" + String(weatherTempC, 1);
        j += ",\"omHum\":" + String(weatherHumidity);
        j += ",\"omHigh\":" + String(weatherHighC, 1);
        j += ",\"omLow\":" + String(weatherLowC, 1);
        j += ",\"omUv\":" + String(weatherUv, 0);
        j += ",\"omWind\":" + String(weatherWindKmh, 0);
        j += ",\"omWindDir\":" + String(weatherWindDir);
        j += ",\"omPressure\":" + String(weatherPressureHpa, 0);
        j += ",\"omDailyProb\":" + String(weatherDailyProb);
        j += ",\"omSunrise\":\"" + String(weatherSunrise) + "\"";
        j += ",\"omSunset\":\"" + String(weatherSunset) + "\"";
        j += ",\"omAge\":" + String(omAge);
        j += "}";
        server.sendHeader("Cache-Control", "no-store, no-cache, must-revalidate");
        server.sendHeader("Pragma", "no-cache");
        server.send(200, "application/json", j);
        return;
    }

    bool dataForCity = weatherDataValid && strcmp(weatherDataCity, settings.weatherCity) == 0;
    bool fresh = dataForCity && weatherDataFresh();
    bool warning = fresh && settings.rainWarn && weatherRainLatched;
    unsigned long age = dataForCity ? (millis() - weatherUpdatedMs) / 1000UL : 0;

    String page;
    page.reserve(5000);
    page += "<!DOCTYPE html><html><head><meta charset=utf-8>"
            "<meta name=viewport content='width=device-width,initial-scale=1'>"
            "<meta name=theme-color content='#0a0d0b'>"
            "<meta http-equiv=refresh content=30>"
            "<title>MatrixClock Details</title><style>"
            ":root{--bg:#0a0d0b;--panel:#121614;--line:#232a26;--accent:#22e07a;--text:#e8f0ec;--sub:#7c8c84}"
            "*{box-sizing:border-box}body{margin:0;background:radial-gradient(900px 420px at 50% -10%,#10241a 0,var(--bg) 62%);color:var(--text);font-family:-apple-system,BlinkMacSystemFont,'Segoe UI',Roboto,Arial,sans-serif;min-height:100vh;padding:22px 16px}"
            ".wrap{max-width:440px;margin:0 auto}h1{font-size:20px;text-align:center;margin:4px 0 6px;color:var(--accent)}h2{font-size:16px;text-align:center;margin:20px 0 8px;color:var(--accent);font-weight:600}"
            ".city{text-align:center;color:var(--sub);font-size:13px;margin:0 0 18px}"
            "table{width:100%;border-collapse:collapse;background:linear-gradient(180deg,#171c19,#121614);border:1px solid var(--line);border-radius:14px;overflow:hidden;box-shadow:0 6px 20px rgba(0,0,0,.18)}"
            "td{padding:12px 14px;border-bottom:1px solid var(--line);font-size:14px}tr:last-child td{border-bottom:none}"
            "td:first-child{color:var(--sub)}td:last-child{text-align:right;font-weight:600}"
            ".yes{color:var(--accent)}.no{color:var(--sub)}.warn{color:#e05252}.ok{color:var(--accent)}.big{font-size:16px}"
            ".note{font-size:12px;line-height:1.6;color:var(--sub);margin:16px 0}.note a{color:var(--accent);text-decoration:none}"
            "</style></head><body><div class=wrap><h1>Clock Details</h1><h2>Rain / Weather</h2><div class=city>";
    page += settings.weatherCity[0] ? settings.weatherCity : "No weather city configured";
    page += "</div><table>";
    if (settings.weatherCity[0] == 0)
        page += "<tr><td>Status</td><td class=no>No weather city configured</td></tr>";
    else if (!settings.weather && !settings.rainWarn && !settings.heatWarn)
        page += "<tr><td>Status</td><td class=no>Weather and warnings are off</td></tr>";
    else if (!dataForCity)
    {
        page += "<tr><td>Status</td><td class=no>Waiting for first check</td></tr>";
        page += "<tr><td>First check</td><td>15 seconds after boot</td></tr>";
    }
    else
    {
        char row[80];
        page += "<tr><td>Rain now</td><td class=big>";
        page += String(weatherPrecipRate, 1);
        page += " mm/h</td></tr><tr><td>Next 1h rain</td><td class=big>";
        page += String(weatherRain1h, 2);
        page += " mm</td></tr><tr><td>Next 2h rain</td><td class=big>";
        page += String(weatherRain2h, 2);
        page += " mm</td></tr><tr><td>Rain chance (2h)</td><td>";
        page += String(weatherPrecipProb);
        page += " %</td></tr><tr><td>Rain code in 2h</td><td>";
        page += weatherRainCodeSoon ? "Yes" : "No";
        page += "</td></tr><tr><td>Next 2h peak</td><td>";
        page += String(weatherRainPeak, 1);
        page += " mm/h</td></tr><tr><td>Today high / low temp.</td><td>";
        page += weatherHighValid ? String(weatherHighC, 1) : "--";
        page += " / ";
        page += weatherLowValid ? String(weatherLowC, 1) : "--";
        page += " &deg;C</td></tr><tr><td>Sunrise / sunset</td><td>";
        page += weatherSunrise[0] ? weatherSunrise : "--:--";
        page += " / ";
        page += weatherSunset[0] ? weatherSunset : "--:--";
        page += "</td></tr><tr><td>Current wind / UV max</td><td>";
        page += String(weatherWindKmh, 0);
        page += " km/h ";
        page += windDirName(weatherWindDir);
        page += " / ";
        page += String(weatherUv, 0);
        page += "</td></tr><tr><td>Pressure / rain chance</td><td>";
        page += String(weatherPressureHpa, 0);
        page += " hPa / ";
        page += String(weatherDailyProb);
        page += " %</td></tr><tr><td>Your threshold</td><td>";
        page += tenthsStr(settings.rainThresh10);
        page += " mm/h</td></tr><tr><td>Rain warning</td><td class=";
        if (!settings.rainWarn) page += "no>Off";
        else if (!fresh) page += "no>Unknown (stale data)";
        else if (warning) page += "warn>ACTIVE";
        else page += "yes>Not triggered";
        page += "</td></tr><tr><td>Temperature</td><td>";
        page += String(weatherTempC, 1);
        page += " &deg;C</td></tr><tr><td>Humidity</td><td>";
        page += String(weatherHumidity);
        page += " %</td></tr><tr><td>Weather code</td><td>";
        page += String(weatherCode);
        page += "</td></tr><tr><td>Last check</td><td>";
        snprintf(row, sizeof row, "%lu s ago", age);
        page += row;
        if (!fresh) page += " (STALE)";
        page += "</td></tr>";
    }
    page += "</table>";
    page += "<div class=note>";
    if (settings.weather || settings.rainWarn || settings.heatWarn)
    {
        page += "The clock checks every ";
        page += String(settings.weatherInterval);
        page += " min. A rain warning is triggered by the current rain rate, by "
                "forecast amount with probability (0.3 mm in the next hour or 0.6 mm "
                "in the next two hours at 60%+ chance), or by a rain weather code. "
                "A warning stays active through one dry check. Data older than three "
                "checks (minimum 45 min) is stale and ignored. This page refreshes "
                "every 30 seconds.<br><br>"
                "Open-Meteo data is model forecast output, not a local rain gauge. "
                "Outside central Europe and North America the 15-minute values are "
                "interpolated from hourly model data.";
        if (!settings.weather && (settings.rainWarn || settings.heatWarn))
            page += "<br><br>Weather messages are off, but warnings are still checked.";
    }
    page += "</div>";
    page += "<h2>NTP</h2><table>";
    page += "<tr><td>Server</td><td>";
    page += settings.ntpServer[0] ? settings.ntpServer : "not set";
    page += "</td></tr>";
    if (ntpLastSyncMs != 0)
    {
        char row[80];
        page += "<tr><td>Ping (round trip)</td><td>";
        page += String(ntpLastRttMs);
        page += " ms</td></tr><tr><td>Time adjustment</td><td>";
        page += String(ntpLastTransitMs);
        page += " ms</td></tr><tr><td>Last sync</td><td>";
        snprintf(row, sizeof row, "%lu s ago", (millis() - ntpLastSyncMs) / 1000UL);
        page += row;
        page += "</td></tr>";
    }
    else
        page += "<tr><td>Status</td><td class=no>Waiting for first sync</td></tr>";
    page += "<tr><td>Failed retries</td><td>";
    page += String(ntpRetryCount);
    page += "</td></tr>";
    if (ntpRetryAt != 0)
    {
        long remain = (long) (ntpRetryAt - millis()) / 1000;
        if (remain < 0) remain = 0;
        page += "<tr><td>Next retry</td><td>";
        page += String(remain);
        page += " s</td></tr>";
    }
    page += "</table>";

    page += "<h2>System</h2><table>";
    page += "<tr><td>Firmware</td><td>" FIRMWARE_VERSION "</td></tr>";
    char sysRow[80];
    unsigned long up = millis() / 1000UL;
    snprintf(sysRow, sizeof sysRow, "%lud %02lu:%02lu:%02lu",
             up / 86400UL, (up / 3600UL) % 24UL, (up / 60UL) % 60UL, up % 60UL);
    page += "<tr><td>Uptime</td><td>";
    page += sysRow;
    page += "</td></tr>";
    page += "<tr><td>Free heap / minimum</td><td>";
    page += String(ESP.getFreeHeap());
    page += " / ";
    page += String(heapMin == 0xFFFFFFFF ? ESP.getFreeHeap() : heapMin);
    page += " B</td></tr>";
    page += "<tr><td>WiFi RSSI / reconnects</td><td>";
    page += String(WiFi.RSSI());
    page += " dBm / ";
    page += String(wifiReconnectCount);
    page += "</td></tr>";
    page += "<tr><td>Reset reason</td><td>";
    page += ESP.getResetReason();
    page += "</td></tr>";
    page += "<tr><td>RTC temperature</td><td>";
    page += String(rtc_temp(), 1);
    page += " &deg;C</td></tr>";
    page += "<tr><td>RTC status</td><td>";
    page += (rtc_osf() ? "LOST TIME" : "OK");
    page += "</td></tr>";
    page += "<tr><td>RTC aging offset</td><td>";
    page += String(rtc_aging());
    page += "</td></tr>";
    page += "<tr><td>Last NTP error</td><td>";
    page += (lastNtpError[0] ? lastNtpError : "none");
    page += "</td></tr>";
    page += "<tr><td>Last weather error</td><td>";
    page += (lastWeatherError[0] ? lastWeatherError : "none");
    page += "</td></tr>";
    page += "</table><div class=note><a href='/'>Back to settings</a></div></div></body></html>";
    sendChunked(200, "text/html", page);
}
//**************************************************************************************************
void handleStatus()
{
    if (!webAuthOk()) { server.requestAuthentication(); return; }
    server.keepAlive(false);
    String j;
    j.reserve(600);
    j = "{\"version\":\"" FIRMWARE_VERSION "\"";
    j += ",\"build\":\"" __DATE__ " " __TIME__ "\"";
    j += ",\"heap\":" + String(ESP.getFreeHeap());
    j += ",\"heapMin\":" + String(heapMin == 0xFFFFFFFF ? ESP.getFreeHeap() : heapMin);
    j += ",\"rssi\":" + String(WiFi.RSSI());
    j += ",\"wifi\":" + String((int) WiFi.status());
    j += ",\"wifiReconnects\":" + String(wifiReconnectCount);
    j += ",\"uptime\":" + String(millis() / 1000UL);
    j += ",\"reset\":\"" + jsonEsc(ESP.getResetReason().c_str()) + "\"";
    j += ",\"sketch\":" + String(ESP.getSketchSize());
    j += ",\"freeSketch\":" + String(ESP.getFreeSketchSpace());
    j += ",\"ota\":" + String(Update.isRunning() ? 1 : 0);
    j += ",\"rtcTemp\":" + String(rtc_temp(), 1);
    j += ",\"rtcOsf\":" + String(rtc_osf() ? 1 : 0);
    j += ",\"rtcAging\":" + String(rtc_aging());
    j += ",\"ntpRtt\":" + String(ntpLastRttMs);
    j += ",\"ntpAdj\":" + String(ntpLastTransitMs);
    j += ",\"ntpAge\":" + String(ntpLastSyncMs ? (millis() - ntpLastSyncMs) / 1000UL : 0);
    j += ",\"ntpRetry\":" + String(ntpRetryCount);
    j += ",\"ntpRetryIn\":" + String(ntpRetryAt ? (long) (ntpRetryAt - millis()) / 1000 : 0);
    j += ",\"lastNtpError\":\"" + jsonEsc(lastNtpError) + "\"";
    j += ",\"lastWeatherError\":\"" + jsonEsc(lastWeatherError) + "\"";
    j += ",\"detailCount\":" + String(weatherDetailCount);
    j += ",\"detailPage\":" + String(weatherDetailLastPage);
    j += ",\"orient\":" + String(settings.orient);
    j += ",\"kk\":" + String(kk ? 1 : 0);
    j += "}";
    server.sendHeader("Cache-Control", "no-store, no-cache, must-revalidate");
    server.sendHeader("Pragma", "no-cache");
    server.send(200, "application/json", j);
}
//**************************************************************************************************
void handleLog()
{
    if (!webAuthOk()) { server.requestAuthentication(); return; }
    String out;
    out.reserve(LOG_LINES * (LOG_CHARS + 20) + 128);
    out = "MatrixClock " FIRMWARE_VERSION "\r\n";
    out += "Reset: " + ESP.getResetReason() + "\r\n";
    out += "Uptime: " + String(millis() / 1000UL) + " s\r\n\r\n";
    uint8_t start = (uint8_t) ((logHead + LOG_LINES - logCount) % LOG_LINES);
    for (uint8_t i = 0; i < logCount; i++)
    {
        uint8_t idx = (uint8_t) ((start + i) % LOG_LINES);
        out += "[" + String(logRing[idx].ms / 1000UL) + "s] ";
        out += logRing[idx].text;
        out += "\r\n";
    }
    server.sendHeader("Cache-Control", "no-store");
    server.keepAlive(false);
    server.send(200, "text/plain; charset=utf-8", out);
}
//**************************************************************************************************
void handleTestDisplay()
{
    if (!webAuthOk()) { server.requestAuthentication(); return; }
    displayTestStart = millis();
    displayTestUntil = displayTestStart + 3000UL;
    server.keepAlive(false);
    server.send(200, "application/json", "{\"ok\":true}");
}
//**************************************************************************************************
void handleScan()
{
    if (!webAuthOk()) { server.requestAuthentication(); return; }
    int n = WiFi.scanNetworks(false, true);   // include hidden SSIDs
    String j;
    j.reserve(1600);
    j = "{\"networks\":[";
    if (n < 0)
        j += "],\"error\":\"scan failed\"}";
    else
    {
        for (int i = 0; i < n; i++)
        {
            if (i) j += ",";
            j += "{\"ssid\":\"" + jsonEsc(WiFi.SSID(i).c_str()) + "\"";
            j += ",\"rssi\":" + String(WiFi.RSSI(i));
            j += ",\"enc\":" + String((int) WiFi.encryptionType(i));
            j += "}";
        }
        j += "]}";
    }
    WiFi.scanDelete();
    server.keepAlive(false);
    server.send(200, "application/json", j);
}
//**************************************************************************************************
void handleReset()
{
    if (!webAuthOk()) { server.requestAuthentication(); return; }
    settings = settings_defaults;
    // Explicit defaults requested for these fields:
    strncpy(settings.ntpServer, "il.pool.ntp.org", sizeof(settings.ntpServer) - 1);
    settings.ntpServer[sizeof(settings.ntpServer) - 1] = '\0';
    settings.rainWarn = 1;
    settings.heatWarn = 1;
    settings.rainThresh = 2;
    settings.heatThresh = 31;
    settings.rainThresh10 = 20;
    settings.heatThresh10 = 310;
    settings.threshFormat = 0xA55A;
    settings.birthdayEnabled = 1;
    settings.birthdayFreq = 60;
    settings.birthdayAnim = 1;
    memset(settings.birthdays, 0, sizeof(settings.birthdays));
    settings.birthdayFormat = 0xB17D;
    settings.holidayFreq = 0;
    settings.greetingFormat = 0xB17E;
    settings.weatherDetails = 1;
    settings.detailFormat = 0xDE7A;
    settings.textEffect = 0;
    settings.textFxFormat = 0xEFF5;
    settings.dateSpeed = 2;
    settings.dateSpeedFormat = 0xDA7E;
    settings.displayTransition = TRANSITION_PACMAN;
    settings.transitionFormat = 0xD158;
    settings_save();
    Serial.printf("Settings reset: NTP=%s rain=%d/%smm heat=%d/%sC\r\n",
                  settings.ntpServer, settings.rainWarn, tenthsStr(settings.rainThresh10).c_str(),
                  settings.heatWarn, tenthsStr(settings.heatThresh10).c_str());
    server.keepAlive(false);
    server.send(200, "application/json", "{\"ok\":true,\"msg\":\"Settings reset. Rebooting...\"}");
    otaRebootAt = millis() + 2000UL;
}
//**************************************************************************************************
void handleTestAnimation()
{
    if (!webAuthOk()) { server.requestAuthentication(); return; }
    uint8_t type = settings.displayTransition;
    if (server.hasArg("type"))
    {
        int v = server.arg("type").toInt();
        if (v >= 0 && v <= TRANSITION_RANDOM)
            type = (uint8_t) v;
    }
    if (!msgEatActive)
        startMsgEatTransition(false, type);
    server.keepAlive(false);
    server.send(200, "application/json", "{\"ok\":true}");
}
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
void loop() {
    //Add your repeated code here
    unsigned int sek1 = 0, sek2 = 0, min1 = 0, min2 = 0, std1 = 0, std2 = 0;
    unsigned int sek11 = 0, sek12 = 0, sek21 = 0, sek22 = 0;
    unsigned int min11 = 0, min12 = 0, min21 = 0, min22 = 0;
    unsigned int std11 = 0, std12 = 0, std21 = 0, std22 = 0;
    unsigned int f_scroll_x = false;

    z_PosX = maxPosX;
    d_PosX = -8;

    refresh_display();
    while (true) {
        loopHeartbeatMs = millis();
        yield();  // on the ESP8266, if the loop must run long operations (e.g. floating point math), call yield regularly so the 8266 keeps running in the background without rebooting or dropping the network.
        handleSerialCommand();
        server.handleClient();   // handle web settings page requests
        if (otaRebootAt != 0 && (long) (millis() - otaRebootAt) >= 0)
        {
            Serial.println("OTA: rebooting");
            ESP.restart();
        }
        if (apUpdatePending != 0 && (long) (millis() - apUpdatePending) >= 0)
        {
            apUpdatePending = 0;
            enterAPUpdateMode();
        }
        if (apUpdateMode)
        {
            static uint8_t lastAPClients = 0;
            uint8_t apClients = WiFi.softAPgetStationNum();
            if (apClients != lastAPClients)
            {
                lastAPClients = apClients;
                apUpdateSince = millis();
            }
            if (!Update.isRunning() && apClients == 0 && millis() - apUpdateSince > 600000UL)
            {
                Serial.println("AP update mode idle 10 min, rebooting");
                ESP.restart();
            }
        }
        bool otaBusy = Update.isRunning() || otaRebootAt != 0;   // do not start blocking NTP/weather work during a firmware update
        static bool wifiReconnectNotify = false;   // set by the 50ms tick when WiFi comes up
        static bool ntpSyncRequested = false;      // set on a genuine reconnect or when leaving AP mode (not the boot connect)
        if (!otaBusy && rtcInitialized && settings.resync && WiFi.status() == WL_CONNECTED)   // daily RTC/NTP resync: sync directly and show the status
        {
            static bool resyncRan = false;
            if (!(MEZ.std12 == settings.resyncHour && MEZ.min12 == settings.resyncMin))
                resyncRan = false;   // re-arm once we leave the resync minute (next day)
            if (MEZ.sek12 == 0 && !resyncRan && MEZ.std12 == settings.resyncHour && MEZ.min12 == settings.resyncMin)
            {
                resyncRan = true;
                tm* tt = connectNTP();
                if (tt != NULL)
                {
                    rtc_set(tt);
                    Serial.println("Daily resync OK");
                    startNtpMessage(tt);
                }
                else
                {
                    Serial.println("Daily resync failed (no NTP reply)");
                    startNtpMessage(NULL);
                }
            }
        }
        if (!otaBusy && rtcInitialized && settings.ntpInterval > 0 && WiFi.status() == WL_CONNECTED)   // periodic NTP sync every ntpInterval minutes
        {
            static unsigned long intervalLastSync = 0;
            static bool intervalArmed = false;
            if (!intervalArmed)
            {
                intervalLastSync = millis();
                intervalArmed = true;
            }
            if ((millis() - intervalLastSync) >= (unsigned long) settings.ntpInterval * 60000UL)
            {
                intervalArmed = false;
                tm* tt = connectNTP();
                if (tt != NULL)
                {
                    rtc_set(tt);
                    Serial.println("Periodic NTP sync OK");
                    startNtpMessage(tt);
                }
                else
                {
                    Serial.println("Periodic NTP sync failed (no NTP reply)");
                    startNtpMessage(NULL);
                }
            }
        }
        bool weatherNeeded = settings.weather || settings.rainWarn || settings.heatWarn;
        if (!otaBusy && rtcInitialized && weatherNeeded && WiFi.status() == WL_CONNECTED && strlen(settings.weatherCity) > 0)   // periodic Open-Meteo update
        {
            static unsigned long weatherLast = 0;
            static bool weatherArmed = false;
            static bool weatherFirst = true;
            if (!weatherArmed)
            {
                weatherLast = millis();
                weatherArmed = true;
                if (weatherFirst)
                    Serial.printf("Weather: active, first check in 15s (city %s, then every %d min)\r\n",
                                  settings.weatherCity, settings.weatherInterval);
                else
                    Serial.printf("Weather: active, next check in %d min (city %s)\r\n",
                                  settings.weatherInterval, settings.weatherCity);
            }
            // Make the first weather check after boot quick, so warnings can be tested
            // without waiting for the full weather interval.
            unsigned long weatherWait = weatherFirst ? 15000UL
                                                     : (unsigned long) settings.weatherInterval * 60000UL;
            if ((millis() - weatherLast) >= weatherWait)
            {
                weatherArmed = false;
                weatherFirst = false;
                Serial.printf("Weather: checking %s...\r\n", settings.weatherCity);
                double temp;
                int hum;
                double precip;
                double rainNext;
                double rain1h;
                double rain2h;
                int prob2h;
                bool codeRainSoon;
                int wmoCode;
                if (fetchWeather(temp, hum, precip, rainNext, wmoCode, rain1h, rain2h, prob2h, codeRainSoon))
                {
                    double rainLimit = settings.rainThresh10 / 10.0;
                    double heatLimit = settings.heatThresh10 / 10.0;
                    bool rainNow = settings.rainWarn && precip >= rainLimit;
                    bool rainCodeNow = settings.rainWarn && isRainCode(wmoCode)
                                    && precip >= 0.05 && prob2h >= RAIN_PROB_NOW_MIN;
                    bool rainSoon = settings.rainWarn && prob2h >= RAIN_PROB_MIN
                                 && (rain1h >= RAIN_AMOUNT_1H_MM || rain2h >= RAIN_AMOUNT_2H_MM);
                    bool rainByCode = settings.rainWarn && codeRainSoon
                                   && prob2h >= RAIN_PROB_MIN
                                   && rain2h >= RAIN_CODE_AMOUNT_2H_MM;
                    bool rainSignal = rainNow || rainCodeNow || rainSoon || rainByCode;

                    if (!settings.rainWarn)
                    {
                        weatherRainLatched = false;
                        weatherRainDryChecks = 0;
                    }
                    else if (rainSignal)
                    {
                        if (!weatherRainLatched)
                            Serial.println("Rain warning: signal detected");
                        weatherRainLatched = true;
                        weatherRainDryChecks = 0;
                        weatherRainLastRate = (float) precip;
                        weatherRainLast1h = (float) rain1h;
                        weatherRainLastProb = prob2h;
                    }
                    else if (weatherRainLatched)
                    {
                        if (weatherRainDryChecks < 255) weatherRainDryChecks++;
                        if (weatherRainDryChecks >= 2)
                        {
                            weatherRainLatched = false;
                            weatherRainDryChecks = 0;
                            Serial.println("Rain warning: cleared after 2 dry checks");
                        }
                    }

                    Serial.printf("Weather check: %.1fC (heat %s, limit %.1f), now %.1fmm/h peak2h %.1fmm/h, 1h %.2fmm 2h %.2fmm prob %d%% codeRain %d (rain %s, limit %.1f, code %d, signal %d, latched %d)\r\n",
                                  temp, settings.heatWarn ? "on" : "off", heatLimit,
                                  precip, rainNext, rain1h, rain2h, prob2h, codeRainSoon ? 1 : 0,
                                  settings.rainWarn ? "on" : "off", rainLimit, wmoCode,
                                  rainSignal ? 1 : 0, weatherRainLatched ? 1 : 0);
                    char buf[160];
                    buf[0] = 0;
                    uint8_t alertType = ALERT_ANIM_NONE;
                    if (weatherRainLatched)
                    {
                        alertType = ALERT_ANIM_RAIN;
                        bool ending = !rainSignal;
                        char chance[24];
                        if (ending)
                        {
                            // Hysteresis: keep the warning for one dry check, but say
                            // clearly that the rain has stopped.
                            formatRainChance(chance, sizeof chance, weatherRainLastProb);
                            if (settings.weatherCityShow)
                                snprintf(buf, sizeof buf, "RAIN ENDING  LAST: %.1f MM/h,  1H: %.1f MM/h,  %s%s  Temp: %.1f ~C, RH: %d %%  ",
                                         weatherRainLastRate, weatherRainLast1h, chance, settings.weatherCity, temp, hum);
                            else
                                snprintf(buf, sizeof buf, "RAIN ENDING  LAST: %.1f MM/h,  1H: %.1f MM/h,  %sTemp: %.1f ~C, RH: %d %%  ",
                                         weatherRainLastRate, weatherRainLast1h, chance, temp, hum);
                        }
                        else if (rainNow || rainCodeNow)
                        {
                            formatRainChance(chance, sizeof chance, prob2h);
                            if (settings.weatherCityShow)
                                snprintf(buf, sizeof buf, "RAIN WARNING !!!  NOW: %.1f MM/h,  1H: %.1f MM/h,  2H: %.1f MM/h,  %s%s  Temp: %.1f ~C, RH: %d %%  ",
                                         precip, rain1h, rain2h, chance, settings.weatherCity, temp, hum);
                            else
                                snprintf(buf, sizeof buf, "RAIN WARNING !!!  NOW: %.1f MM/h,  1H: %.1f MM/h,  2H: %.1f MM/h,  %sTemp: %.1f ~C, RH: %d %%  ",
                                         precip, rain1h, rain2h, chance, temp, hum);
                        }
                        else
                        {
                            formatRainChance(chance, sizeof chance, prob2h);
                            if (settings.weatherCityShow)
                                snprintf(buf, sizeof buf, "RAIN LIKELY  1H: %.1f MM/h,  2H: %.1f MM/h,  %s%s  Temp: %.1f ~C, RH: %d %%  ",
                                         rain1h, rain2h, chance, settings.weatherCity, temp, hum);
                            else
                                snprintf(buf, sizeof buf, "RAIN LIKELY  1H: %.1f MM/h,  2H: %.1f MM/h,  %sTemp: %.1f ~C, RH: %d %%  ",
                                         rain1h, rain2h, chance, temp, hum);
                        }
                    }
                    else if (settings.heatWarn && temp >= heatLimit)
                    {
                        alertType = ALERT_ANIM_HEAT;
                        if (settings.weatherCityShow)
                            snprintf(buf, sizeof buf, "HEAT WARNING: %.1f ~C  %s  Outside Temp: %.1f ~C , RH: %d %%", heatLimit, settings.weatherCity, temp, hum);
                        else
                            snprintf(buf, sizeof buf, "HEAT WARNING: %.1f ~C  Outside Temp: %.1f ~C , RH: %d %%", heatLimit, temp, hum);
                    }
                    else if (settings.weather)
                    {
                        if (settings.weatherCityShow)
                            snprintf(buf, sizeof buf, "%s  Outside Temp: %.1f ~C , RH: %d %%", settings.weatherCity, temp, hum);
                        else
                            snprintf(buf, sizeof buf, "Outside Temp: %.1f ~C , RH: %d %%", temp, hum);
                    }

                    if (buf[0] == 0)
                    {
                        // Warnings-only mode and no warning: nothing to display.
                    }
                    else if (alertType != ALERT_ANIM_NONE && settings.warnAnim)
                    {
                        weatherAlertActive = true;
                        weatherAlertMsgActive = false;
                        startAlertAnimation(alertType, buf, settings.weatherSpeed);
                        f_scroll_x = false;   // discard any date scroll; the alert has priority
                    }
                    else if (alertType != ALERT_ANIM_NONE)
                    {
                        // Warn without animation, but still give the warning priority over a
                        // running Shabbat/holiday message or animation.
                        weatherAlertActive = true;
                        weatherAlertMsgActive = true;
                        alertAnimActive = false;
                        showMsg = false;
                        msgQueueCount = 0;
                        startMsg(buf, settings.weatherSpeed);
                        f_scroll_x = false;
                    }
                    else
                    {
                        startMsg(buf, settings.weatherSpeed);
                        if (settings.weatherDetails && weatherDetailsValid)
                        {
                            static uint8_t detailTick = 0;
                            static uint8_t detailPage = 0;
                            if (++detailTick >= 4)
                            {
                                detailTick = 0;
                                char detail[120];
                                buildWeatherDetail(detail, sizeof detail, detailPage);
                                weatherDetailLastPage = detailPage;
                                weatherDetailCount++;
                                detailPage = (uint8_t) ((detailPage + 1) % 5);
                                startMsg(detail, settings.weatherSpeed);
                            }
                        }
                    }
                }
                else if (settings.weather)
                    startMsg("WEATHER FAIL");
            }
        }
        if (f_tckr1s == true)        // flag 1sek
        {kk = (settings.orient == 2) ? 1 : 0;                   // manual normal/flipped
            uint32_t heapNow = ESP.getFreeHeap();
            if (heapNow < heapMin) heapMin = heapNow;
            static uint8_t heapLowCount = 0;
            if (heapNow < 4000 && !otaBusy)
            {
                if (++heapLowCount >= 10)
                {
                    logLine("Heap low %lu B, rebooting", (unsigned long) heapNow);
                    delay(20);
                    ESP.restart();
                }
            }
            else
                heapLowCount = 0;
            static unsigned int wifiCheckCnt = 0;
            static bool reconnectActive = false;
            static unsigned long reconnectStart = 0;
            static uint8_t reconnectFailures = 0;
            static bool ntpSyncPending = false;
            static bool ntpSyncArm = false;

            if (!apUpdateMode && WiFi.status() == WL_CONNECTED)
            {
                wifiCheckCnt = 0;
                reconnectActive = false;
                reconnectFailures = 0;
                if (apActive)
                {
                    stopAP();   // router is back, fallback AP no longer needed
                    ntpSyncRequested = true;   // leaving AP mode -> resync the RTC once
                }
            }
            if (!apUpdateMode && wifiReconnectNotify)   // WiFi came up (boot or auto/manual reconnect)
            {
                wifiReconnectNotify = false;
                logLine("WiFi connected, IP %s", WiFi.localIP().toString().c_str());
                if (ntpSyncRequested)   // genuine reconnection, or leaving AP mode -> resync the RTC once
                {
                    wifiReconnectCount++;
                    logLine("WiFi reconnect #%u", wifiReconnectCount);
                    startMsg("Wi-Fi Connected");
                    ntpSyncArm = true;
                    ntpSyncRequested = false;
                }
            }
            else if (!apUpdateMode)   // keep trying the router even while the fallback AP is up
            {
                if (!reconnectActive)
                {
                    if (++wifiCheckCnt >= WIFI_CHECK_INTERVAL)   // check WiFi every 30s
                    {
                        wifiCheckCnt = 0;
                        wifi_reconnect_start();
                        reconnectActive = true;
                        reconnectStart = millis();
                    }
                }
                else if (millis() - reconnectStart > 10000)   // give up after 10s
                {
                    Serial.println("WiFi reconnect failed, will retry later");
                    reconnectActive = false;
                    wifiCheckCnt = 0;
                    reconnectFailures++;
                    if (!apActive && !apUpdateMode && reconnectFailures >= 3)
                    {
                        Serial.println("WiFi failed repeatedly, starting setup AP");
                        reconnectFailures = 0;
                        startAP();
                    }
                    if (apActive)
                    {
                        WiFi.setAutoReconnect(false);   // stop the SDK's background retry so the fallback AP stays responsive
                        WiFi.disconnect(false, false);
                    }
                }
            }

            if (!apUpdateMode && apShutdownPending && millis() - apShutdownSince > 8000)   // defer the opmode switch until the link has settled
            {
                apShutdownPending = false;
                if (WiFi.status() == WL_CONNECTED)
                {
                    WiFi.softAPdisconnect(true);
                    WiFi.mode(WIFI_STA);
                    Serial.println("AP stopped");
                }
                else
                {
                    apActive = true;   // router dropped again during the grace period: keep the fallback AP
                    apMsgUntil = millis() + 30000UL;
                    Serial.println("WiFi dropped again, keeping fallback AP");
                }
            }

            if (ntpSyncArm)   // one tick delay so the "Wi-Fi Connected" scroll is not blocked by connectNTP()
            {
                ntpSyncArm = false;
                ntpSyncPending = true;
            }
            if (!apUpdateMode && ntpSyncPending && !otaBusy)   // resync RTC once after a successful reconnect
            {
                ntpSyncPending = false;
                tm* tt = connectNTP();
                if (tt != NULL)
                {
                    rtc_set(tt);
                    Serial.println("RTC resynced after WiFi reconnect");
                    startNtpMessage(tt);
                    ntpRetryAt = 0;
                    ntpRetryCount = 0;
                }
                else
                {
                    Serial.println("no time packet received");
                    startNtpMessage(NULL);
                    ntpRetryAt = millis() + 30000UL;
                    ntpRetryCount = 0;
                }
            }
            if (!apUpdateMode && ntpRetryAt != 0 && !otaBusy && WiFi.status() == WL_CONNECTED
                && (long) (millis() - ntpRetryAt) >= 0)
            {
                ntpRetryAt = 0;
                tm* tt = connectNTP();
                if (tt != NULL)
                {
                    rtc_set(tt);
                    startNtpMessage(tt);
                    ntpRetryCount = 0;
                }
                else if (ntpRetryCount < 5)
                {
                    ntpRetryCount++;
                    unsigned long retryDelay = 30000UL << (ntpRetryCount - 1);
                    if (retryDelay > 300000UL) retryDelay = 300000UL;
                    ntpRetryAt = millis() + retryDelay;
                }
            }
            rtc2mez();
            rtcInitialized = true;
            sek1 = MEZ.sek1;
            sek2 = MEZ.sek2;
            min1 = MEZ.min1;
            min2 = MEZ.min2;
            std1 = MEZ.std1;
            std2 = MEZ.std2;
            sek1++;
            if (sek1 == 10) {
                sek2++;
                sek1 = 0;
            }
            if (sek2 == 6) {
                min1++;
                sek2 = 0;
            }
            if (min1 == 10) {
                min2++;
                min1 = 0;
            }
            if (min2 == 6) {
                std1++;
                min2 = 0;
            }
            if (std1 == 10) {
                std2++;
                std1 = 0;
            }
            if ((std2 == 2) && (std1 == 4)) {
                std1 = 0;
                std2 = 0;
            }

            sek11 = sek12;
            sek12 = sek1;
            sek21 = sek22;
            sek22 = sek2;
            min11 = min12;
            min12 = min1;
            min21 = min22;
            min22 = min2;
            std11 = std12;
            std12 = std1;
            std21 = std22;
            std22 = std2;
            f_tckr1s = false;
            {
                static uint16_t lastMinute = 0xFFFF;
                uint16_t nowMin = (uint16_t) (MEZ.std12 * 60 + MEZ.min12);
                if (nowMin != lastMinute)
                {
                    lastMinute = nowMin;
                    shabbatMinuteTick(nowMin);
                    holidayTick();
                    birthdayTick();
                }
            }
            if (settings.scrollDate && !alertAnimActive)   // scroll the date at the chosen interval
            {
                static unsigned short lastScrollMin = 0xFFFF;
                unsigned short minuteOfDay = MEZ.std12 * 60 + MEZ.min12;
                if (minuteOfDay != lastScrollMin)
                {
                    lastScrollMin = minuteOfDay;
                    if (minuteOfDay % settings.scrollDateInt == 0)
                        f_scroll_x = true;
                }
            }
            if (!showMsg && !f_scroll_x && !alertAnimActive)   // start transitions for the digits that changed
            {
                uint8_t newVals[6] = { (uint8_t) sek1, (uint8_t) sek2, (uint8_t) min1,
                                       (uint8_t) min2, (uint8_t) std1, (uint8_t) std2 };
                uint8_t oldVals[6] = { (uint8_t) sek11, (uint8_t) sek21, (uint8_t) min11,
                                       (uint8_t) min21, (uint8_t) std11, (uint8_t) std21 };
                uint8_t changed[6] = { (uint8_t) (newVals[0] != oldVals[0]),
                                       (uint8_t) (newVals[1] != oldVals[1]),
                                       (uint8_t) (newVals[2] != oldVals[2]),
                                       (uint8_t) (newVals[3] != oldVals[3]),
                                       (uint8_t) (newVals[4] != oldVals[4]),
                                       (uint8_t) (newVals[5] != oldVals[5]) };
                for (uint8_t i = 0; i < 6; i++) {
                    if (changed[i]) digitAnimStart(i, oldVals[i], newVals[i]);
                    else if (digitAnim[i].active) digitAnim[i].active = false;
                }
            }
            else
                digitAnimCancelAll();
        } // end 1s
        if (f_tckr50ms == true) {// the following runs every 50ms to control scroll speed
            f_tckr50ms = false;
            if (displayTestUntil != 0 && !Update.isRunning() && otaRebootAt == 0)
            {
                if ((long) (millis() - displayTestUntil) >= 0)
                    displayTestUntil = 0;
                else
                {
                    clearLEDarr();
                    unsigned long elapsed = millis() - displayTestStart;
                    if (elapsed < 1000)
                    {
                        for (uint8_t x = 0; x <= maxPosX; x++)
                            for (uint8_t y = 0; y < 8; y++)
                                setLedPixel(x, y);
                    }
                    else if (elapsed < 2000)
                    {
                        for (uint8_t x = 0; x <= maxPosX; x++)
                            for (uint8_t y = 0; y < 8; y++)
                                if ((x + y) & 1) setLedPixel(x, y);
                    }
                    else
                    {
                        for (uint8_t x = 0; x <= maxPosX; x++)
                            for (uint8_t y = 0; y < 8; y++)
                                if (((x >> 2) + y) & 1) setLedPixel(x, y);
                    }
                    refresh_display();
                    continue;
                }
            }
            if (Update.isRunning() && otaRebootAt == 0)
                continue;   // keep the display/SPI quiet while firmware is being written
            if (msgEatActive)   // a display-change transition is running
            {
                clearLEDarr();
                drawMsgEatAnimation();
                refresh_display();
                continue;
            }
            if (alertAnimActive)   // show the rain/heat icon first, then scroll the warning text
            {
                unsigned long elapsed = millis() - alertAnimStartMs;
                if (elapsed < ALERT_ANIM_MS)
                {
                    clearLEDarr();
                    drawAlertAnimation(alertAnimType, (uint16_t) (elapsed / 50));
                    refresh_display();
                    continue;
                }
                bool wasWeatherAlert = (alertAnimType == ALERT_ANIM_RAIN || alertAnimType == ALERT_ANIM_HEAT);
                alertAnimActive = false;
                showMsg = false;
                msgQueueCount = 0;
                startMsg(alertAnimMsg, alertAnimSpeed);
                if (wasWeatherAlert)
                    weatherAlertMsgActive = true;
            }
            // Announce "Wi-Fi Connected" only when a link that had been stably up for a while
            // drops and comes back. A fixed boot-time grace period is not enough: the link often
            // settles with one extra drop/reconnect shortly after boot, which would otherwise be
            // mistaken for a genuine reconnection and announce on every boot.
            static bool wifiPrevUp = false;
            static bool wifiStable = false;      // link continuously up for >= WIFI_STABLE_MS
            static bool stableBeforeDrop = false;
            static unsigned long upSinceMs = 0;
            const unsigned long WIFI_STABLE_MS = 90000UL;
            bool wifiUp = (WiFi.status() == WL_CONNECTED);
            if (wifiUp != wifiPrevUp)   // link state changed
            {
                Serial.printf("WiFi link %s (had been stable: %d)\r\n", wifiUp ? "up" : "down", stableBeforeDrop);
                if (!wifiUp)
                    stableBeforeDrop = wifiStable;   // remember stability at the moment of the drop
                else
                {
                    wifiReconnectNotify = true;
                    if (stableBeforeDrop)   // link had been stably up before the drop -> genuine reconnect
                        ntpSyncRequested = true;
                }
                upSinceMs = millis();
                wifiStable = false;
            }
            else if (wifiUp && !wifiStable && millis() - upSinceMs >= WIFI_STABLE_MS)
                wifiStable = true;
            wifiPrevUp = wifiUp;
            if (showMsg) {
                z_PosX += 2;
                d_PosX += msgStep;
                int msgWidth = 0;
                for (int mi = 0; msg[mi] != 0; mi++) {
                    int k = (int)(unsigned char) msg[mi] - 32;
                    msgWidth += (k >= 0 && k < 96) ? font1[k][0] : 4;   // non-ASCII bytes count as a space width (never index font1 OOB)
                }
                if (d_PosX > 31 + msgWidth + 8) {   // whole message has scrolled past
                    z_PosX = maxPosX;
                    d_PosX = -8;
                    showMsg = false;
                    max7219_set_brightness(settings.brightness);
                    if (weatherAlertMsgActive)   // warning finished; let Shabbat/holiday messages through again
                    {
                        weatherAlertMsgActive = false;
                        weatherAlertActive = false;
                    }
                    if (otaRebootAt != 0 && otaUploadSuccess)
                        startMsgNow("UPDATE SUCCESSFUL", 2, false);   // keep showing it until the reboot
                    else if (apActive && millis() < apMsgUntil)   // keep repeating the AP setup hint for 30 seconds
                        startMsg(apUpdateMode ? "AP UPDATE 192.168.4.1" : "SETUP MODE AP 192.168.4.1");
                }
            }
            else if (msgQueueCount > 0) {
                startNextQueuedMsg();
            }
            else if (f_scroll_x == true) {
                uint8_t steps = (settings.dateSpeed < 1 || settings.dateSpeed > 3) ? 2 : settings.dateSpeed;
                for (uint8_t s = 0; s < steps; s++) {
                    z_PosX++;
                    d_PosX++;
                    if (d_PosX == 101)
                        z_PosX = 0;
                    if (z_PosX == maxPosX) {
                        f_scroll_x = false;
                        d_PosX = -8;
                        break;
                    }
                }
            }
            if (!showMsg)
                clearLEDarr();   // rebuild the frame from scratch: no animation/scroll trails

            if (showMsg) {
                int mi, mx = d_PosX;
                digitAnimCancelAll();
                clearLEDarr();   // erase clock digits + scroll trails so the message scrolls cleanly
                int msgYOff = 0;
                bool drawMsg = true;
                int enterPx = d_PosX + 8;   // how far the message has entered from the left
                if (enterPx < 0) enterPx = 0;
                if (enterPx > 40) enterPx = 40;
                uint8_t enterLevel = (uint8_t) ((enterPx * 16) / 40);
                if (settings.textEffect == 4)
                    drawMsg = ((millis() / 250UL) & 1UL) == 0;   // blink
                if (drawMsg)
                {
                    for (mi = 0; msg[mi] != 0; mi++) {
                        int k = (int)(unsigned char) msg[mi] - 32;
                        if (k >= 0 && k < 96)
                            char2Arr(msg[mi], mx - 1, msgYOff);
                        mx -= (k >= 0 && k < 96) ? font1[k][0] : 4;   // step by the actual glyph width; non-ASCII bytes use a space width
                    }
                }
                if (settings.textEffect == 1 && enterLevel < 16)
                    fadeMessage(enterLevel);   // dither fade; no global brightness pumping
            }
            else if (msgEatActive) {
                drawMsgEatAnimation();
            }
            else {
                if (f_scroll_x)
                    digitAnimCancelAll();   // no transitions while the clock is scrolling sideways

                drawDigitCell(0, (uint8_t) sek1, z_PosX - 27, true);   // seconds ones (small font)
                drawDigitCell(1, (uint8_t) sek2, z_PosX - 23, true);   // seconds tens
                drawDigitCell(2, (uint8_t) min1, z_PosX - 18, false);  // minutes ones
                drawDigitCell(3, (uint8_t) min2, z_PosX - 13, false);  // minutes tens
                drawColon(z_PosX - 10);
                drawDigitCell(4, (uint8_t) std1, z_PosX - 4, false);   // hours ones
                drawDigitCell(5, (uint8_t) std2, z_PosX + 1, false);   // hours tens
                if (f_scroll_x)
                    drawDate(d_PosX);   // the date is only visible while scrolling
            }

            refresh_display(); //alle 50ms
        } //end 50ms
    }  //end while(true)
    //this section can not be reached
}
