antoxa78/Matrix_Clock_v3/firmware/MatrixClock/WebJs.h

#pragma once
#include <Arduino.h>

// Settings page JavaScript. Run tools/pack_web_assets.py after editing.

static const char APP_JS[] PROGMEM = R"JSCONTENT(function E(s){return String(s).replace(/&/g,'&amp;').replace(/"/g,'&quot;').replace(/</g,'&lt;');}var IC={network:'<svg class=ic viewBox="0 0 24 24"><path d="M5 12.55a11 11 0 0 1 14.08 0"/><path d="M8.53 16.11a6 6 0 0 1 6.95 0"/><line x1="12" y1="20" x2="12.01" y2="20"/></svg>',clock:'<svg class=ic viewBox="0 0 24 24"><circle cx="12" cy="12" r="9"/><polyline points="12 7 12 12 15 14"/></svg>',display:'<svg class=ic viewBox="0 0 24 24"><rect x="2" y="4" width="20" height="13" rx="2"/><line x1="8" y1="21" x2="16" y2="21"/><line x1="12" y1="17" x2="12" y2="21"/></svg>',weather:'<svg class=ic viewBox="0 0 24 24"><path d="M18 10h-1.26A8 8 0 1 0 9 20h9a5 5 0 0 0 0-10z"/></svg>',events:'<svg class=ic viewBox="0 0 24 24"><rect x="3" y="4" width="18" height="18" rx="2"/><line x1="16" y1="2" x2="16" y2="6"/><line x1="8" y1="2" x2="8" y2="6"/><line x1="3" y1="10" x2="21" y2="10"/></svg>',system:'<svg class=ic viewBox="0 0 24 24"><path d="M20 7h-9"/><path d="M14 17H5"/><circle cx="17" cy="17" r="3"/><circle cx="7" cy="7" r="3"/></svg>',details:'<svg class=ic viewBox="0 0 24 24"><circle cx="11" cy="11" r="7"/><line x1="21" y1="21" x2="16.65" y2="16.65"/></svg>',top:'<svg class=ic viewBox="0 0 24 24"><polyline points="18 15 12 9 6 15"/></svg>'};var GROUPS=[[IC.network+' Network',['ssid','pass','webPass','apPass']],[IC.clock+' Clock',['ntp','tz','dst','resync','resyncHour','resyncMin','ntpInterval','scrollDate','scrollDateInt','dateSpeed']],[IC.display+' Display',['bright','orient','colonAnim','digitAnim','scrollDir','textEffect','displayTransition']],[IC.weather+' Weather',['weather','weatherCity','weatherCityShow','weatherInterval','weatherSpeed','weatherDetails','rainWarn','rainThresh','heatWarn','heatThresh','warnAnim']],[IC.events+' Events',['shabbat','shabbatFreq','shabbatLead','shabbatAnim','holidayGreetings','holidayFreq','birthdayEnabled','birthdayFreq','birthdayAnim','bday1','bday2','bday3','bday4','bday5','bday6']]];var BOUNDS={bright:[0,15],scrollDateInt:[1,120],resyncHour:[0,23],resyncMin:[0,59],ntpInterval:[0,720],weatherInterval:[1,240],rainThresh:[0.1,25],heatThresh:[20,50]};var DESCS={
ssid:"WiFi network name (2.4 GHz only).",
apPass:"Password for the MatrixClock-Setup Wi-Fi network (8-63 characters). Default: 12345678.",
ntp:"Pick a preset NTP server or type a custom hostname.",
tz:"Hours from UTC. Example: 2 for Israel.",
dst:"Daylight-saving rule. Auto follows the selected region.",
bright:"LED brightness: 0 = dim, 15 = brightest.",
orient:"Norm for upright mounting; Flip for upside-down mounting.",
scrollDate:"Slide the date across the display at the chosen interval.",
scrollDateInt:"Minutes between date scrolls.",
dateSpeed:"How fast the date scroll moves.",
scrollDir:"Direction of Roll, Flip, Wipe, Drop and Fade digit changes.",
colonAnim:"Colon blinking style.",
digitAnim:"Animation when a clock digit changes.",
textEffect:"How scrolling messages enter the display.",
displayTransition:"Animation between the clock and a new message.",
resync:"Re-sync the clock with NTP once a day.",
resyncHour:"Hour of the daily NTP resync (0-23).",
resyncMin:"Minute of the daily NTP resync (0-59).",
ntpInterval:"Extra NTP sync every N minutes; 0 = off.",
weather:"Scroll current weather and temperature messages.",
weatherCityShow:"Include the city name in weather messages.",
weatherInterval:"Minutes between weather checks.",
weatherSpeed:"Scroll speed for weather messages.",
weatherDetails:"Rotate extra forecast pages after every 4th weather update.",
rainWarn:"Warn when rain is detected or forecast.",
rainThresh:"Current rain rate that triggers a warning (mm/h).",
heatWarn:"Warn when the outside temperature is very high.",
heatThresh:"Outside temperature that triggers a heat warning (°C).",
warnAnim:"Play the rain/heat icon animation before the warning text.",
shabbat:"Show Shabbat candle-lighting and Havdalah reminders.",
shabbatFreq:"Repeat interval for Shabbat reminders.",
shabbatLead:"Minutes before candle lighting to show the reminder.",
shabbatAnim:"Show the candle animation with the reminder.",
birthdayEnabled:"Show birthday greetings.",
birthdayFreq:"Repeat interval for birthday greetings; 0 = once per day.",
birthdayAnim:"Show the birthday animation.",
bday1Name:"Name and date (DD/MM/YYYY); year is optional.",
holidayGreetings:"Show holiday greetings.",
holidayFreq:"Repeat interval for holiday greetings; 0 = once per day."
};function isToggle(x){var o=x[2];return o&&o.length==2&&o[0][0]=='0'&&o[0][1]=='Off'&&o[1][0]=='1'&&o[1][1]=='On';}function field(x){if(isToggle(x)){return '<label class=row><span class=toggle><span class=k>'+E(x[0])+'</span><span class=sw><input type=checkbox name="'+x[1]+'" value=1'+(x[3]=='1'?' checked':'')+'><i></i></span></span></label>';}if(x[2]=='birthday'){var p=String(x[3]).split('|');var nm=p[0]||'';var dt=p.length>1?p.slice(1).join('|'):'';return '<div class=row><span>'+E(x[0])+'</span><div class=bdayrow><input name="'+x[1]+'Name" value="'+E(nm)+'" placeholder="Name" autocomplete=off spellcheck=false><input name="'+x[1]+'Date" value="'+E(dt)+'" placeholder="DD/MM/YYYY" autocomplete=off spellcheck=false></div></div>';}if(x[1]=='displayTransition'){var h='<div class=row><span>'+E(x[0])+'</span><select name=displayTransition>';for(var k=0;k<x[2].length;k++)h+='<option value="'+x[2][k][0]+'"'+(x[2][k][0]==x[3]?' selected':'')+'>'+E(x[2][k][1])+'</option>';return h+'</select><button type=button id=testanimbtn class="actionbtn backup" style="margin-top:10px">Test Display Transition</button></div>';}if(x[1]=='ntp'){var servers=['il.pool.ntp.org','pool.ntp.org','time.google.com','time.cloudflare.com','time.windows.com','time.apple.com','time.nist.gov','ntp.aliyun.com','asia.pool.ntp.org','europe.pool.ntp.org','north-america.pool.ntp.org','south-america.pool.ntp.org','africa.pool.ntp.org','oceania.pool.ntp.org'];var h='<div class=row><span>'+E(x[0])+'</span><select id=ntpSelect><option value="">Custom...</option>';for(var k=0;k<servers.length;k++)h+='<option value="'+servers[k]+'"'+(servers[k]==x[3]?' selected':'')+'>'+servers[k]+'</option>';return h+'</select><input name=ntp value="'+E(x[3])+'" type=text autocomplete=off autocapitalize=off spellcheck=false placeholder="Custom NTP hostname"></div>';}if(x[2]){var h='<div class=row><span>'+E(x[0])+'</span><select name="'+x[1]+'">';for(var k=0;k<x[2].length;k++)h+='<option value="'+x[2][k][0]+'"'+(x[2][k][0]==x[3]?' selected':'')+'>'+E(x[2][k][1])+'</option>';return h+'</select></div>';}if(x[1]=='pass'){return '<div class=row><span>'+E(x[0])+'</span><div class=pwrap><input type=password id=pw name="'+x[1]+'" value="'+E(x[3])+'" autocomplete=new-password autocapitalize=off spellcheck=false><button type=button id=pwt>Show</button></div><div class=hint style="text-align:left;padding:6px 0 0">Leave blank to keep the saved WiFi password.</div></div>';}if(x[1]=='webPass'){return '<div class=row><span>'+E(x[0])+'</span><input type=password name="webPass" value="'+E(x[3])+'" autocomplete=new-password autocapitalize=off spellcheck=false><div class=hint style="text-align:left;padding:6px 0 0">Username: admin. Leave blank to disable login.</div></div>';}if(x[1]=='apPass'){return '<div class=row><span>'+E(x[0])+'</span><input type=password name=apPass value="" autocomplete=new-password autocapitalize=off spellcheck=false placeholder="Leave blank to keep current"><div class=hint style="text-align:left;padding:6px 0 0">8-63 characters. Default: 12345678.</div></div>';}if(x[1]=='weatherCity'){return '<div class=row><span>'+E(x[0])+'</span><input name="weatherCity" value="'+E(x[3])+'" type=text autocomplete=off autocapitalize=off spellcheck=false><div class=hint style="text-align:left;padding:6px 0 0">Required for weather and Shabbat, even when Weather Messages is off.</div></div>';}var b=BOUNDS[x[1]],extra;if(b){var dec=x[1]=='rainThresh'||x[1]=='heatThresh';extra=' type=number inputmode='+(dec?'decimal':'numeric')+' min='+b[0]+' max='+b[1]+(dec?' step=0.1':'');}else if(x[1]=='tz')extra=' type=number inputmode=numeric';else extra=' type=text autocomplete=off autocapitalize=off spellcheck=false';return '<div class=row><span>'+E(x[0])+'</span><input name="'+x[1]+'" value="'+E(x[3])+'"'+extra+'></div>';}function markActiveCat(){var n=document.getElementById('catnav');if(!n)return;var top=n.offsetHeight+8,best=null;document.querySelectorAll('.card[id]').forEach(function(f){if(f.getBoundingClientRect().top<=top)best=f;});var id=best?best.id:'';if(id==='maint'||id==='danger')id='backup';var links=n.querySelectorAll('a');for(var i=0;i<links.length;i++)links[i].classList.toggle('active',!!id&&links[i].getAttribute('href')==='#'+id);}
function navMetrics(){var n=document.getElementById('catnav');if(!n)return;document.documentElement.style.setProperty('--nav-h',(n.offsetHeight+14)+'px');markActiveCat();}
fetch('/v').then(function(r){return r.json();}).then(function(d){try{sessionStorage.removeItem('cfgRetry');}catch(e){}var used={};GROUPS.forEach(function(g){g[1].forEach(function(k){used[k]=1;});});var byKey={};d.f.forEach(function(x){byKey[x[1]]=x;});var html='',nav='<a href="#">'+IC.top+' Top</a><a href="/weather">'+IC.details+' Details</a>';GROUPS.forEach(function(g,gi){var rows='';g[1].forEach(function(k){if(byKey[k])rows+=field(byKey[k]);});if(g[0].indexOf('Network')>=0)rows='<div class=row><span>Scan for WiFi</span><div class=scanrow><button type=button class=scanbtn id=scanbtn>Scan</button><select id=scanlist><option value="">Tap Scan...</option></select></div><div class=scanhint id=scanhint>Select a network to fill the SSID field.</div></div>'+rows;if(rows){html+='<div class="card" id="cat'+gi+'"><div class=cardhead>'+g[0]+'</div><div class=cardbody>'+rows+'</div></div>';nav+='<a href="#cat'+gi+'">'+g[0]+'</a>';}});var other='';d.f.forEach(function(x){if(!used[x[1]])other+=field(x);});if(other)html+='<div class="card"><div class=cardhead>Other</div><div class=cardbody>'+other+'</div></div>';document.getElementById('fields').innerHTML=html;Array.prototype.forEach.call(document.querySelectorAll('#fields [name]'),function(el){var d=DESCS[el.name];if(!d)return;var row=el.closest('.row');if(!row||row.querySelector('.desc'))return;var sp=document.createElement('span');sp.className='desc';sp.textContent=d;if(el.name==='displayTransition'&&el.nextSibling)row.insertBefore(sp,el.nextSibling);else row.appendChild(sp);});document.addEventListener('change',function(e){if(!e.target||e.target.id!=='ntpSelect')return;var i=document.querySelector('[name=ntp]');if(!i)return;if(e.target.value)i.value=e.target.value;else i.focus();});var dsel=document.querySelector('[name=displayTransition]');if(dsel)dsel.addEventListener('change',function(){if(this.value==='0')return;fetch('/testanim?type='+encodeURIComponent(this.value),{method:'POST'}).catch(function(){});});var cn=document.getElementById('catnav');if(cn)cn.innerHTML=nav+'<a href="#backup">'+IC.system+' System</a>';navMetrics();window.addEventListener('resize',navMetrics);window.addEventListener('scroll',markActiveCat,{passive:true});var pwt=document.getElementById('pwt');if(pwt)pwt.onclick=function(){var p=document.getElementById('pw');if(p.type=='password'){p.type='text';pwt.textContent='Hide';}else{p.type='password';pwt.textContent='Show';}};var sb=document.getElementById('scanbtn'),sl=document.getElementById('scanlist');if(sb)sb.onclick=function(){sb.textContent='Scanning...';var sh=document.getElementById('scanhint');if(sh)sh.textContent='Scanning...';fetch('/scan').then(function(r){return r.json();}).then(function(d){sl.innerHTML='';var a=d.networks||[];for(var i=0;i<a.length;i++){if(!a[i].ssid)continue;var o=document.createElement('option');o.value=a[i].ssid;o.textContent=a[i].ssid+' ('+a[i].rssi+' dBm)'+(a[i].enc?' *':'');sl.appendChild(o);}if(!a.length)sl.innerHTML='<option value="">No networks found</option>';if(sh)sh.textContent=a.length?('Found '+a.length+' networks. Select one to fill SSID.'):'No networks found.';sb.textContent='Scan';}).catch(function(){sb.textContent='Scan';sl.innerHTML='<option value="">Scan failed</option>';if(sh)sh.textContent='Scan failed. Try again.';});};if(sl)sl.onchange=function(){var s=document.querySelector('[name=ssid]');if(s&&sl.value)s.value=sl.value;};}).catch(function(){var f=document.getElementById('fields');if(f)f.innerHTML='<p class=hint>Waiting for clock to come back...</p>';var n=0;try{n=Number(sessionStorage.getItem('cfgRetry')||0);}catch(e){}if(n<20){try{sessionStorage.setItem('cfgRetry',n+1);}catch(e){}setTimeout(function(){location.reload();},3000);}else if(f){f.innerHTML='<p class=hint>Could not load settings. <a href="/" style="color:var(--accent)">Retry</a></p>';}});fetch('/status').then(function(r){return r.json();}).then(function(s){var w=document.getElementById('wifichip'),h=document.getElementById('heapchip'),v=document.getElementById('ver'),u=document.getElementById('uptimechip'),r=document.getElementById('rtcchip');if(v&&s.version)v.textContent='Firmware '+s.version;if(w)w.textContent='WiFi '+s.rssi+' dBm';if(h)h.textContent=Math.round(s.heap/1024)+' KB free';if(u){var t=Number(s.uptime)||0,d=Math.floor(t/86400),hh=Math.floor(t/3600)%24,mm=Math.floor(t/60)%60,ss=t%60;u.textContent='Uptime '+(d?d+'d ':'')+(hh<10?'0':'')+hh+':'+(mm<10?'0':'')+mm+':'+(ss<10?'0':'')+ss;u.title='Last reset: '+(s.reset||'unknown');}if(r&&s.rtcTemp!==undefined){r.textContent='RTC '+Number(s.rtcTemp).toFixed(1)+' °C'+(s.rtcOsf?' LOST TIME':'');r.className='chip'+(s.rtcOsf?' warn':'');r.title='Aging offset: '+(s.rtcAging!==undefined?s.rtcAging:'?');}}).catch(function(){});document.getElementById('f').addEventListener('submit',function(){var b=document.getElementById('sb');b.classList.add('busy');b.textContent='Saving...';});var rb=document.getElementById('resetbtn');if(rb)rb.onclick=function(){if(!confirm('Reset ALL clock settings to defaults? This cannot be undone.'))return;rb.disabled=true;rb.textContent='Resetting...';fetch('/reset',{method:'POST'}).then(function(r){return r.json();}).then(function(){document.body.innerHTML='<div style="padding:48px 20px;text-align:center;color:#e8f0ec;font-family:sans-serif"><h2 style="color:#22e07a">Settings reset</h2><p>Rebooting...</p></div>';setTimeout(function(){location.href="/";},15000);}).catch(function(){rb.disabled=false;rb.textContent='Reset Clock Settings';alert('Reset failed');});};function loadW(){fetch('/weather?format=json',{cache:'no-store'}).then(function(r){return r.json();}).then(function(w){var el=document.getElementById('wbox');if(!el)return;var h='';if(w.city)h+='<span class=chip>'+E(w.city)+'</span>';if(w.omValid)h+='<span class=chip>Model <b>'+Number(w.omNow).toFixed(1)+' mm/h</b></span>';if(w.omValid)h+='<span class=chip>Rain Chance <b>'+Number(w.omProb||0)+'%</b></span>';if(w.omStale)h+='<span class="chip warn">Data stale</span>';h+='<span class=chip>Threshold <b>'+Number(w.threshold).toFixed(1)+'</b> mm/h</span>';h+='<span class="chip'+(w.warning?' warn':(w.rainWarn?' ok':'')) + '">'+(w.warning?'RAIN WARNING':(w.rainWarn?'No rain warning':'Rain warning off'))+'</span>';el.innerHTML=h;}).catch(function(){var el=document.getElementById('wbox');if(el)el.innerHTML='<span class=chip>Weather unavailable</span>';});}var tdb=document.getElementById('testdisplaybtn');if(tdb)tdb.onclick=function(){tdb.disabled=true;tdb.textContent='Testing...';fetch('/testdisplay',{method:'POST'}).then(function(){setTimeout(function(){tdb.disabled=false;tdb.textContent='Test Display';},3500);}).catch(function(){tdb.disabled=false;tdb.textContent='Test Display';});};loadW();setInterval(loadW,30000);var bbtn=document.getElementById('backupbtn'),rbtn=document.getElementById('restorebtn'),rfile=document.getElementById('restorefile');
if(bbtn)bbtn.onclick=function(){var f=document.getElementById('f'),o={version:'matrixclock-settings',fields:{}};for(var i=0;i<f.elements.length;i++){var e=f.elements[i];if(!e.name||e.name=='pass'||e.name=='webPass'||e.name=='apPass'||e.type=='file'||e.type=='submit'||e.type=='button')continue;o.fields[e.name]=(e.type=='checkbox')?(e.checked?'1':'0'):e.value;}var blob=new Blob([JSON.stringify(o,null,2)],{type:'application/json'});var a=document.createElement('a');a.href=URL.createObjectURL(blob);a.download='matrixclock-settings.json';document.body.appendChild(a);a.click();setTimeout(function(){URL.revokeObjectURL(a.href);a.remove();},1000);};
if(rbtn&&rfile){rbtn.onclick=function(){rfile.click();};rfile.onchange=function(){var file=rfile.files[0];if(!file)return;var rd=new FileReader();rd.onload=function(){try{var o=JSON.parse(rd.result),f=document.getElementById('f');if(!o.fields)throw 0;if(!confirm('Restore settings from this backup?'))return;for(var i=0;i<f.elements.length;i++){var e=f.elements[i];if(!e.name||!(e.name in o.fields))continue;if(e.type=='checkbox')e.checked=String(o.fields[e.name])=='1';else e.value=o.fields[e.name];}f.submit();}catch(err){alert('Invalid settings backup');}};rd.readAsText(file);rfile.value='';};}
var rstbtn=document.getElementById('restartbtn');if(rstbtn)rstbtn.onclick=function(){if(confirm('Restart the clock?')){location.href='/reboot';}};document.addEventListener('click',function(e){var t=e.target;if(!t||t.id!=='testanimbtn')return;var s=document.querySelector('[name=displayTransition]');var type=s?s.value:'';t.disabled=true;var old=t.textContent;t.textContent='Playing...';fetch('/testanim?type='+encodeURIComponent(type),{method:'POST'}).then(function(){setTimeout(function(){t.disabled=false;t.textContent=old;},2500);}).catch(function(){t.disabled=false;t.textContent=old;alert('Animation failed');});});)JSCONTENT";
