antoxa78/Matrix_Clock_v3/firmware/MatrixClock/WebCss.h

#pragma once
#include <Arduino.h>

// Settings page stylesheet. Run tools/pack_web_assets.py after editing.

static const char APP_CSS[] PROGMEM = R"CSSCONTENT(:root{--bg:#0a0d0b;--panel:#121614;--panel2:#171c19;--line:#232a26;--accent:#22e07a;--accentd:#1a9c58;--text:#e8f0ec;--sub:#7c8c84}*{box-sizing:border-box}html,body{margin:0}body{background:radial-gradient(900px 420px at 50% -10%,#10241a 0,var(--bg) 62%);color:var(--text);font-family:-apple-system,BlinkMacSystemFont,'Segoe UI',Roboto,Arial,sans-serif;-webkit-tap-highlight-color:transparent;min-height:100vh}.wrap{max-width:480px;margin:0 auto;padding:22px 16px 96px}h1{font-size:20px;text-align:center;margin:4px 0 10px;color:var(--accent);letter-spacing:.4px;text-shadow:0 0 18px rgba(34,224,122,.35)}.chips{display:flex;gap:8px;justify-content:center;flex-wrap:wrap;margin:0 0 18px;padding:8px 10px;background:var(--panel);border:1px solid var(--line);border-radius:12px}.chip{font-size:11px;color:var(--sub);background:var(--panel);border:1px solid var(--line);border-radius:999px;padding:4px 10px;letter-spacing:.03em}.card{border:1px solid var(--line);border-radius:14px;background:linear-gradient(180deg,var(--panel2),var(--panel));margin:0 0 14px;box-shadow:0 6px 20px rgba(0,0,0,.18);overflow:hidden}.cardhead{background:var(--panel2);border-bottom:1px solid var(--line);padding:9px 14px;font-size:11px;font-weight:600;letter-spacing:.08em;text-transform:uppercase;color:var(--accentd);line-height:1.2}.cardbody{padding:4px 14px 6px}.row{display:block;padding:10px 0;border-bottom:1px solid var(--line)}.row:last-child{border-bottom:none}.row>span{display:block;font-size:12.5px;color:var(--sub);margin-bottom:5px}input[type=text],input[type=password],input[type=number],select{width:100%;padding:11px 12px;font-size:16px;color:var(--text);background:var(--panel2);border:1px solid var(--line);border-radius:9px;outline:none;transition:border-color .15s,box-shadow .15s}input:focus,select:focus{border-color:var(--accent);box-shadow:0 0 0 3px rgba(34,224,122,.15)}.pwrap{position:relative}.pwrap input{padding-right:52px}.pwrap button{position:absolute;right:4px;top:4px;bottom:4px;width:44px;background:none;border:none;color:var(--sub);font-size:11px;text-transform:uppercase;letter-spacing:.05em}.row>.toggle{display:flex;align-items:center;justify-content:space-between;padding:2px 0}.toggle .k{font-size:13.5px;color:var(--text)}.sw{position:relative;width:46px;height:27px;flex:none;display:inline-block}.sw input{position:absolute;opacity:0;width:100%;height:100%;margin:0;cursor:pointer}.sw i{position:absolute;inset:0;background:#2b332e;border-radius:27px;transition:.15s;pointer-events:none}.sw i:before{content:'';position:absolute;width:21px;height:21px;left:3px;top:3px;background:#e8f0ec;border-radius:50%;transition:.15s}.sw input:checked+i{background:var(--accentd)}.sw input:checked+i:before{transform:translateX(19px);background:#fff}.savebar{position:sticky;bottom:0;padding:12px 0 calc(12px + env(safe-area-inset-bottom));background:linear-gradient(180deg,transparent,var(--bg) 35%);backdrop-filter:blur(8px);box-shadow:0 -8px 18px rgba(0,0,0,.35)}button#sb{width:100%;padding:15px;font-size:15.5px;font-weight:600;background:var(--accent);color:#04150b;border:none;border-radius:12px;box-shadow:0 4px 18px rgba(34,224,122,.3);transition:filter .15s,transform .1s}button#sb:hover{filter:brightness(1.06)}button#sb:active{transform:scale(.98)}button#sb.busy{opacity:.6}.actionbtn{width:100%;padding:15px;font-size:15.5px;font-weight:600;border:none;border-radius:12px;display:block;text-align:center;text-decoration:none;box-sizing:border-box;transition:filter .15s,transform .1s}.actionbtn:active{transform:scale(.98)}.actionbtn.update{background:#2563eb;color:#fff;box-shadow:0 4px 18px rgba(37,99,235,.35)}.actionbtn.update:hover{filter:brightness(1.12)}.actionbtn.restart{background:#2b1414;border:1px solid #5a2a2a;color:#ff9a9a}.actionbtn.backup{background:var(--panel2);border:1px solid var(--line);color:var(--accent)}.actionbtn+.actionbtn{margin-top:10px}.hint{font-size:12.5px;color:var(--sub);text-align:center;padding:16px 0}.row>span.desc{display:block;font-size:11.5px;line-height:1.4;color:var(--sub);margin:6px 0 0;text-align:left}.bdayrow{display:flex;gap:8px;align-items:center}.bdayrow input:first-child{flex:1.3}.bdayrow input:last-child{flex:1}html{scroll-behavior:smooth}#fields{padding-top:8px}.catnav{display:grid;grid-template-columns:repeat(auto-fit,minmax(104px,1fr));gap:6px;padding:7px 0 12px;position:sticky;top:0;z-index:8;background:var(--bg);border-bottom:1px solid var(--line);box-shadow:0 6px 12px rgba(0,0,0,.18)}.catnav a{display:flex;align-items:center;justify-content:center;text-align:center;min-height:42px;font-size:11.5px;line-height:1.4;color:var(--accent);background:var(--panel);border:1px solid var(--line);border-radius:9px;padding:9px 6px;text-decoration:none;transition:background .15s,border-color .15s,transform .1s}.catnav a:hover{border-color:var(--accentd);background:var(--panel2)}.catnav a:active{transform:scale(.97)}.catnav a.active{background:var(--accentd);border-color:var(--accentd);color:#04150b}.card{scroll-margin-top:var(--nav-h,140px)}.ver{font-size:11.5px;color:var(--sub);text-align:center;margin:-14px 0 20px;letter-spacing:.04em}.scanrow{display:flex;gap:8px;align-items:center}.scanrow select{flex:1;width:auto}.scanbtn{padding:11px 14px;background:var(--panel2);border:1px solid var(--line);border-radius:9px;color:var(--accent);font-size:13px;font-weight:600;transition:border-color .15s}.scanbtn:hover{border-color:var(--accent)}.scanhint{font-size:11px;color:var(--sub);margin-top:6px}.card.danger{border-color:#5a2a2a;background:linear-gradient(180deg,#1e1212,#170f0f)}.card.danger .cardhead{background:#1e1212;border-bottom-color:#5a2a2a}.dangerbtn{width:100%;padding:13px;background:#e05252;color:#fff;border:none;border-radius:10px;font-weight:600;font-size:14px}#testanimbtn{padding:11px 14px;min-height:40px;font-size:13px;font-weight:600;box-shadow:none}#ntpSelect{margin-bottom:8px}.wbox{display:flex;gap:8px;justify-content:center;flex-wrap:wrap;margin:0 0 18px;padding:10px 12px;background:var(--panel);border:1px solid var(--line);border-radius:12px}.wbox .chip{font-size:11.5px;background:var(--panel2)}.wbox .chip b{color:var(--text);font-weight:600}.wbox .warn{color:#e05252;border-color:#5a2a2a}.wbox .ok{color:var(--accent);border-color:var(--accentd)}.wbox a.chip{text-decoration:none}.ic{width:1.05em;height:1.05em;stroke:currentColor;fill:none;stroke-width:1.9;stroke-linecap:round;stroke-linejoin:round;vertical-align:-0.14em;margin-right:3px;flex:none}.cardhead .ic{width:18px;height:18px;margin-right:6px;vertical-align:-3px}.catnav a .ic{width:15px;height:15px;margin-right:3px;vertical-align:-2px}.ic-title{width:26px;height:26px;margin-right:8px;vertical-align:-5px}.actionbtn .ic,.dangerbtn .ic{width:16px;height:16px;margin-right:6px;vertical-align:-3px})CSSCONTENT";
