antoxa78/Matrix_Clock_v3/(commit log)

2026-08-15 Initial commit of Matrix Clock v3
    [hack_clock-B_Cu.gbl, hack_clock-B_Mask.gbs, hack_clock-B_Paste.gbp, hack_clock-B_SilkS.gbo, hack_clock-Edge_Cuts.gm1, hack_clock-F_Cu.gtl, hack_clock-F_Mask.gts, hack_clock-F_Paste.gtp]
2026-08-15 Add led clock original firmware Y4025
2026-08-16 Version 2.1: RTT-corrected NTP sync
    [MatrixClock.ino]
2026-08-16 Version 2.1: fix AP mode, show AP setup hint, sync RTC on leaving AP mode
    [MatrixClock.ino]
2026-08-20 Version 2.2: fix NTP validation, improve save response, mask passwords, rebuild bins
    - NTP: replace delay(1000) with poll loop that keeps web server responsive
    during sync; accept cb>=48; reject LI=3/stratum-0/version-invalid
    - NTP: guard RTT underflow; log leap-second announcements (LI=1/2)
    - handleSave: close TCP cleanly before restart, increase delay to 2s so
    browser receives the full response page instead of staying on /save
    - rtc2mez: clamp day to 1-31, month already clamped to 1-12
    - Remove unused global tm *tt
    - Mask WiFi password in all serial log outputs
    - Rebuild firmware binaries (generic DOUT, nodemcu DIO, 4MB flash)
    [MatrixClock.ino]
2026-08-21 Version 2.3: fix incomplete settings page, firmware version banner, clearer status messages, stable-link reconnect detection
    - sendChunked: zero-copy chunked responses; the previous per-chunk substring()
    allocation could silently fail under heap fragmentation and skip bytes,
    leaving holes in the middle of the page (settings page sometimes incomplete)
    - Settings page: show installed firmware version below the title banner
    - Display messages: 'NTP TIME SYNC OK!' -> 'NTP Clock Sync. Successful.',
    'WI-FI OK' -> 'Wi-Fi Connected'
    - Reconnect announcement now requires the link to have been continuously up
    for >=90s before a drop, so the boot-time link flap no longer announces
    'Wi-Fi Conn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
    [MatrixClock.ino]
2026-08-28 Fix WiFi reconnect after AP fallback mode
    - WiFi.disconnect() erases stored credentials; use disconnect(false,false)
    everywhere so the saved SSID/passphrase survive AP mode
    - re-enable SDK auto-reconnect during each reconnect probe (disabled again
    on give-up so the fallback AP stays responsive)
    - defer softAP shutdown by 8s after reconnect: switching the opmode in the
    same instant the station connection completes crashed the SDK
    - trigger an immediate NTP resync on a genuine reconnect (link was stable
    before the drop), not just when leaving AP mode
    - persist SmartConfig credentials into settings so later reconnects use them
    - rebuild firmware binaries
    [MatrixClock.ino]
2026-08-28 Version 2.4: fix NTP sync after AP fallback mode
    - NTP resync now arms when leaving AP fallback mode: stopAP() sets
    ntpSyncRequested, so the sync is requested even when the 1s tick clears
    apActive before the 50ms link-up handler runs (previously skipped entirely)
    - call udp.begin() unconditionally in setup(): AP-mode boots skipped the
    udp.begin() inside autoConfig()/smartConfig(), so every later NTP attempt
    (reconnect, daily resync, periodic sync) had no UDP socket and failed
    - rebuild firmware binaries (generic DOUT, nodemcu DIO, 1MB layout keeps the
    settings sector at 0xFB000)
    [MatrixClock.ino]
2026-08-28 Rebuild v2.4 firmware for 4MB flash (ESP-12S)
    The module is an ESP-12S with 4MB flash (confirmed via flash_id, the
    hardware footprint, and the original factory firmware header). The v2.x
    builds had regressed to a 1MB layout, leaving 3MB unused. Rebuilt with the
    4M3M layout (generic DOUT, nodemcu DIO), which moves the EEPROM settings
    sector from 0xFB000 back to 0x3FB000 to match the factory firmware.
    Settings were migrated in place so no reconfiguration is needed.
2026-11-06 v5.7: holiday greetings, rain warning fixes, remove test mode
    Add selected holiday greetings with animations and a settings toggle; honor the configured rain threshold and show current/forecast rain values; give rain/heat warnings priority so Shabbat/holiday messages cannot cover them; remove the 30-second Shabbat test mode; add the optimized WebPage.h settings page and rebuild the generic firmware.
    [MatrixClock.ino]
2026-11-06 Rebuild v5.7 NodeMCU binary (was still v2.4)
    The nodemcu image was left at the v2.4 build when v5.7 was committed,
    so ESP-12S boards flashed with it still used the old rain logic: it only
    warned when current precipitation was at or above the threshold and
    ignored the next-2h forecast. Rebuild it from the same v5.7 source as
    the generic image so both firmware files include the rain forecast and
    warning-priority fixes.
2026-11-06 v5.8: decimal rain/heat thresholds, remove generic image
    Store rain and heat thresholds in tenths (12 = 1.2 mm, 355 = 35.5 C)
    while keeping the old whole-number fields at their original offsets so
    v2.4/v5.7 EEPROM settings migrate without a reset. The settings page now
    accepts one decimal place and shows e.g. 1.2 instead of 1.
    Only the NodeMCU/ESP-12S image is kept and rebuilt; the generic board
    image is no longer needed for this clock and caused confusion when it was
    left stale.
    [MatrixClock.ino]
2026-11-06 v5.9: consistent rain-rate units and weather data page
    Open-Meteo current precipitation is a 15-minute sum; normalize it to
    mm/h so it is comparable with the configured threshold. Use the 15-minute
    series for a rolling next-2h peak instead of two hourly buckets, and let
    actual precipitation trigger the current warning without requiring a
    matching WMO weather code.
    Add /weather, linked from the settings page, showing the last current
    rate, next-2h peak, threshold, warning state, temperature, humidity and
    data age so the numbers can be compared in a browser.
2026-11-06 v5.11: weather source selector (Open-Meteo / hybrid / IMS only)
    Replace the IMS on/off toggle with a three-way Weather Source setting:
    Open-Meteo, IMS + Open-Meteo, or IMS only. IMS-only uses the local
    station for current conditions, rain warnings, heat warnings and routine
    weather messages, with no forecast. Hybrid keeps the Open-Meteo forecast
    while using local IMS rain when fresh. The /weather page now reports the
    active source and hides Open-Meteo data in IMS-only mode.
    [MatrixClock.ino]
2026-11-06 Add 4M1M v5.11 and bridge images for failed OTA updates
    v5.11 is about 526 KB with HTTPS support. After v5.10 the 4M3M layout
    leaves too little free OTA space, so add a v5.11 4M1M image plus a small
    v5.9 4M1M bridge image. The bridge fits the current slot and switches
    the layout; the full v5.11 image can then be uploaded. Document the
    two-step web update and serial flashing options.
2026-11-06 v5.14: read IMS XML in non-blocking chunks
    Split the IMS HTTPS fetch into start and pump phases. The TLS handshake
    and headers still connect synchronously, but the 25 KB XML body is now
    read in at most 512-byte chunks from the main loop, so the clock digits
    keep refreshing instead of freezing for the whole download. Abort an
    active IMS read if an OTA update starts.
2026-11-06 v5.15: heap-safe IMS fetch to stop restarts
    Allocate the IMS fetch state, TLS client and HTTP client only while a
    fetch is active, then free them. This restores the v5.13 memory
    behaviour and avoids keeping TLS objects alive between fetches. Add a
    24 KB free-heap guard, watchdog feed around the TLS handshake, and log
    the reset reason at boot.
    [MatrixClock.ino]
2026-11-06 v5.16: show clock uptime in settings header
    Add an uptime chip next to the free-memory chip, formatted as
    days/hours/minutes/seconds. Include the last ESP reset reason in /status
    and show it as the chip tooltip, so a restart is visible from the
    settings page.
    [MatrixClock.ino]
2026-11-07 v5.17: retry router connection while fallback AP is active
    The reconnect block was guarded by !apActive, so once the setup AP
    started the clock never tried the configured router again until reboot.
    Keep the AP_STA fallback AP reachable but continue the normal 30-second
    station reconnect attempts. On success the existing stopAP path shuts
    the AP down.
    [MatrixClock.ino]
2026-11-07 v5.18: reboot only when WiFi credentials change
    Most settings take effect immediately from the shared settings struct.
    Stop restarting the clock after every save; reboot only when the SSID or
    WiFi password changed, so the station reconnect can start cleanly.
    Otherwise return to settings after 2 seconds.
    [MatrixClock.ino]
2026-11-07 v5.19: fix stale weather summary, add restart button
    Disable browser/HTTP caching for /v, /status and the /weather JSON view,
    and refresh the settings-page weather summary every 30 seconds. This
    prevents the top summary from showing an old warning state after changing
    Weather Source. Add a Restart Clock button at the bottom of settings.
    [MatrixClock.ino]
2026-11-07 v5.20: wait for clock after update/reboot; retry settings load
    Replace the fixed 15-second redirect after OTA with /status polling so
    the browser returns to settings only when the clock is actually back.
    Make /reboot and the new /restart alias show a polling page instead of
    plain text. The settings page now retries /v automatically for up to 60
    seconds after a reboot instead of showing a permanent load error.
    [MatrixClock.ino]
2026-11-07 v5.21: group firmware update and restart in Maintenance
    Give Firmware Update and Restart Clock full-width buttons matching the
    Save Settings size, and place them together in a Maintenance section at
    the bottom of the settings form.
2026-11-07 v5.22: remove IMS provider, simplify to Open-Meteo, blue update button
    Delete the IMS station table, XML fetch, HTTPS/BearSSL dependency,
    weather-source selector and IMS settings. Weather warnings now use
    Open-Meteo current precipitation and next-2h peak only. Remove the
    obsolete 4M1M bridge image and update note. Change the Firmware Update
    button from green to blue.
2026-11-07 v5.23: fix weather-city toggle reverting after save
    Unchecked checkboxes are omitted from the POST body. Treat a missing
    weatherCityShow, warnAnim, shabbat or shabbatAnim field as Off instead of
    leaving the previous value unchanged.
    [MatrixClock.ino]
2026-11-07 v5.24: show synced time in NTP message
    Replace the generic NTP success text with the actual synced time, e.g.
    NTP OK 19:42, and use clear NTP SYNC FAILED messages at boot, periodic
    resync and reconnect failures.
    [MatrixClock.ino]
2026-11-07 v5.25: family birthday greetings
    Add six birthday entries with name and DD/MM/YYYY date, optional birth
    year for age calculation, an enable switch, repeat interval and birthday
    animation. Greetings show a cake/balloons animation and text such as
    HAPPY BIRTHDAY ANNA! 7 YEARS OLD. Also fix the full-year calculation used
    by holiday and birthday scheduling.
    [MatrixClock.ino]
2026-11-07 v5.26: holiday frequency, birthday rows, settings backup
    Use the birthday-style frequency options for holiday greetings with a
    new Holiday Message Frequency setting. Group each birthday name and date
    on one row. Add Backup & Restore controls that download/restore the
    settings form as JSON; WiFi and web passwords stay device-local.
2026-11-07 v5.28: improve rain detection
    Use Open-Meteo precipitation probability, 1h/2h accumulation and WMO rain
    codes in addition to the current rain rate. Add hysteresis so a warning
    survives one dry check and then clears, and mark weather data stale after
    three intervals (minimum 45 min). Run weather checks even when Weather
    Messages is off, so rain/heat warnings keep working independently. Show
    the new values and stale state on the weather page and settings summary.
2026-11-07 v5.3.1: clearer rain warning and compact settings menu
    Add !!! to the rain warning header and label temperature/humidity as
    T and RH. Remove the dashed pipe separator that looked like stray pixels
    before the T/RH block and use double-space groups instead.
    Improve the settings page with a wrapping category grid, active-section
    highlight, smooth anchor scrolling, a weather summary card, and a dynamic
    scroll offset for the taller sticky menu.
2026-11-07 v5.3.2: format rain warning for readability
    Use the requested layout with labelled NOW/1H/2H values, explicit MM/h
    units, chance, lowercase t for temperature and RH for humidity. Keep
    double-space groups and no pipe separators.
2026-11-08 v5.3.7: use degree symbol in all temperature messages
    Use the display degree glyph with C in rain warning, rain likely, rain
    ending, heat warning and normal weather messages.
2026-11-08 v5.4.1: restore grid menu and fix section heading overlap
    [MatrixClock.ino]
2026-11-08 v5.4.5: show current wind speed
2026-11-09 v5.4.6: smoother message effects and shorter transitions
    [MatrixClock.ino]
2026-11-09 v5.4.9: smaller Pac-Man, three ghosts, brightness fix
    [MatrixClock.ino]
2026-11-10 v5.7.4: redesign Tetris transition and fix OTA upload freeze
    [MatrixClock.ino]
2026-11-10 v5.7.15: retry NTP after transient sync failures
    [MatrixClock.ino]
2026-11-10 v5.7.17: replace settings emoji icons with crisp SVG line icons
    [MatrixClock.ino]
2026-11-13 v5.7.21: keep the clock responsive during settings page loads
    The settings page is served synchronously from the main loop. While the 28 KB page was being written, the 50 ms display refresh could not run, so the clock looked frozen; a stalled socket could block the loop long enough for the 30 s watchdog to reboot the clock.
    Add an ETag to / so repeat visits revalidate with a tiny 304 instead of streaming the full page again. Cap every chunked response at 6 s and refresh the loop heartbeat while sending, so a slow browser can neither freeze the display indefinitely nor trigger a false watchdog reset.
    [MatrixClock.ino]
2026-11-13 v5.7.22: faster web transfers on slow WiFi links
    The first v5.7.21 build capped a response at 6 s, which was too short for the clock's real ~1.5 KB/s WiFi link: the 28 KB settings page was truncated.
    Disable Nagle on web responses and send 1 KB chunks. With Nagle enabled, each small chunk waited for a delayed ACK, making the settings page take ~19 s. Keep the hard cap at 45 s so the complete page can still load on a slow link, and keep refreshing the loop heartbeat during the transfer so the watchdog does not reboot the clock.
    [MatrixClock.ino]
2026-11-13 v5.7.23: cache the settings JSON with an ETag
    The settings page fetches /v on every visit. On the clock's weak 2.4 GHz link this 3.5 KB response is the slowest part of the menu and can stall for seconds even when the page HTML is already cached.
    Hash the exact JSON body plus the firmware version into an ETag and return 304 when the browser already has that version. Any settings change produces a new hash, so a cached response can never show stale values. Cache-Control is private/no-cache, keeping the data behind the Basic auth boundary while allowing revalidation.
    [MatrixClock.ino]
2026-11-13 v5.7.24: gzip and cache the settings assets
    Split the 28 KB settings page into a 4 KB HTML shell, a 6.8 KB stylesheet and a 17.6 KB script. CSS and JS are served from separate ETag-cached endpoints and gzipped from PROGMEM: 1.3 KB, 2.1 KB and 6.0 KB respectively.
    The page shell, CSS, JS and /v all return 304 on a repeat visit. This removes the large blocking transfers that made the clock look frozen while the settings menu loaded.
    Also service the clock display every 250 ms while an HTTP response is being written, so even the first gzipped asset transfer cannot stop the time display. This cooperative approach avoids the extra per-connection heap that an async web server library would need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
    [MatrixClock.ino, WebCss.h, WebJs.h]
